someonelse20/Multi-ESC/images/2026-10-27-082640_hyprshot.png

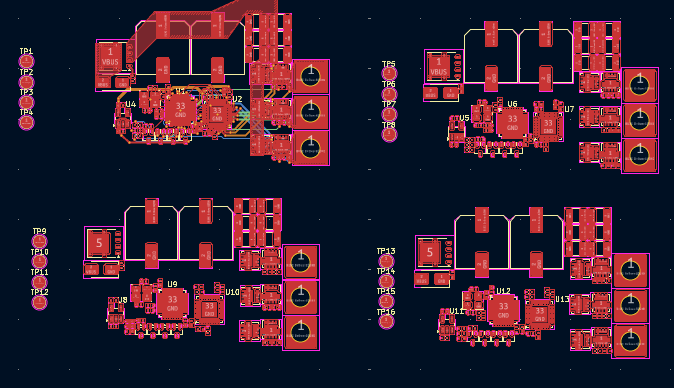
images/2026-10-27-082640_hyprshot.png
