someonelse20/Multi-ESC/images/2026-10-27-082704_hyprshot.png

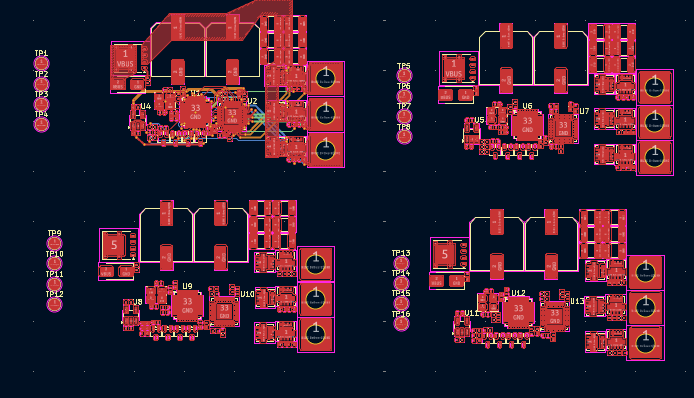
images/2026-10-27-082704_hyprshot.png
