someonelse20/Multi-ESC/production/DigiKeyBOM.csv

Country of Origin may be different at time of shipment.
The HTSUS and ECCN information shown is for informational purposes only and is not a representation or warranty as to the accuracy or reliability of these classifications. All information is provided "as is" and is subject to change without notice. Any use made of the information provided is without recourse to Digi-Key and at the user's risk.
Index | Manufacturer Part Number | Manufacturer Name | Description | Lead Time | Availability | Stock Status | Attrition % | Requested Quantity 1 | Pack Quantity 1 | Pack Type 1 | Digi-Key Part Number 1 | Unit Price 1 | Extended Price 1 | Minimum Order Quantity 1 | Customer Reference | Requested Part Number | Lead Weeks | Datasheet | Reference Designator | US Import Tariff | Note | Part Status | RoHS Status | REACH Status | Moisture Sensitivity Level (MSL) | ECCN | HTSUS | Country of Origin | Environmental Information | Original Part numbers | Unit of Measure | Image | Product Notes
1 | SKRKAEE020 | Alps Alpine | SWITCH TACTILE SPST-NO 0.05A 12V |  | 3,846 | In Stock |  | 2 | 2 | Cut Tape (CT) | 4809-SKRKAEE020CT-ND | 0.41000 | $0.82 | 1 |  | 4809-SKRKAEE020CT-ND | 32 | https://tech.alpsalpine.com/cms.media/product_spec_skrkaee020_en_6e94c25fb8.pdf |  | May apply on shipments to the U.S. |  | Active | ROHS3 Compliant |  | 1 (Unlimited) | EAR99 | 8536.50.9031 | China |  | 4809-SKRKAEE020CT-ND | Each | https://mm.digikey.com/Volume0/opasdata/d220001/medias/images/5355/MFG_SKRKAEE020.jpg
2 | C0603C104K5RACTU | KEMET | CAP CER 0.1UF 50V X7R 0603 |  | 2,150,453 | In Stock |  | 10 | 10 | Cut Tape (CT) | 399-C0603C104K5RACTUCT-ND | 0.07700 | $0.77 | 1 |  | 399-C0603C104K5RACTUCT-ND | 12 | https://yageogroup.com/content/datasheet/asset/file/KEM_C1002_X7R_SMD |  | May apply on shipments to the U.S. |  | Active | ROHS3 Compliant | REACH Unaffected | 1 (Unlimited) | EAR99 | 8532.24.0020 | China |  | 399-C0603C104K5RACTUCT-ND | Each | https://mm.digikey.com/Volume0/opasdata/d220001/derivates/6/003/121/213/cut-tape-render_web%28640x640%29.jpg
3 | CL32B106KBJNNNE | Samsung Electro-Mechanics | CAP CER 10UF 50V X7R 1210 |  | 565,889 | In Stock |  | 30 | 30 | Cut Tape (CT) | 1276-3387-1-ND | 0.42800 | $12.84 | 1 |  | 1276-3387-1-ND | 61 | https://mm.digikey.com/Volume0/opasdata/d220001/medias/docus/41/CL32B106KBJNNNE_Spec.pdf |  | May apply on shipments to the U.S. |  | Active | ROHS3 Compliant | REACH Unaffected | 1 (Unlimited) | EAR99 | 8532.24.0020 | Philippines | https://www.samsungsem.com/files/fileDown.do?key=ed1dfdfa-645e-4252-b707-17f9b1502dd1|https://www.samsungsem.com/global/support/certificate/product-stewardship.do | 1276-3387-1-ND | Each | https://mm.digikey.com/Volume0/opasdata/d220001/medias/images/2537/Ceramic-Capacitor-CL-Series.jpg
4 | CL05A475MO5NUNC | Samsung Electro-Mechanics | CAP CER 4.7UF 16V X5R 0402 | Estimated in-stock date unavailable due to product's market conditions | 10,051 | In Stock |  | 10 | 10 | Cut Tape (CT) | 1276-6836-1-ND | 0.31600 | $3.16 | 1 |  | 1276-6836-1-ND | 61 | https://mm.digikey.com/Volume0/opasdata/d220001/medias/docus/2822/CL05A475MO5NUNC_Spec.pdf |  | May apply on shipments to the U.S. |  | Active | ROHS3 Compliant | REACH Unaffected | 1 (Unlimited) | EAR99 | 8532.24.0020 | Philippines | https://www.samsungsem.com/files/fileDown.do?key=ed1dfdfa-645e-4252-b707-17f9b1502dd1|https://www.samsungsem.com/global/support/certificate/product-stewardship.do | 1276-6836-1-ND | Each | https://mm.digikey.com/Volume0/opasdata/d220001/derivates/6/003/231/753/CL-0402%281005Metric%29_web%28640x640%29.jpg
5 | GCM155R71H104KE02D | Murata Electronics | CAP CER 0.1UF 50V X7R 0402 |  | 3,933,488 | In Stock |  | 20 | 20 | Cut Tape (CT) | 490-10672-1-ND | 0.03500 | $0.70 | 1 |  | 490-10672-1-ND | 21 | https://pim.murata.com/asset/pim4/ceramicCapacitorSMD/GCM155R71H104KE02-01A-EN_PDF_CERAMICCAPACITORSMD |  | May apply on shipments to the U.S. |  | Active | ROHS3 Compliant | REACH Unaffected | 1 (Unlimited) | EAR99 | 8532.24.0020 | Japan |  | 490-10672-1-ND | Each | https://mm.digikey.com/Volume0/opasdata/d220001/derivates/6/003/121/213/cut-tape-render_web%28640x640%29.jpg
6 | UMK107AB7105KA-T | Taiyo Yuden | CAP CER 1UF 50V X7R 0603 |  | 573,908 | In Stock |  | 10 | 10 | Cut Tape (CT) | 587-3247-1-ND | 0.11700 | $1.17 | 1 |  | 587-3247-1-ND | 25 | https://mm.digikey.com/Volume0/opasdata/d220001/medias/docus/506/UMK107AB7105KA-T_SS.pdf |  | May apply on shipments to the U.S. |  | Active | ROHS3 Compliant | REACH Unaffected | 1 (Unlimited) | EAR99 | 8532.24.0020 | Malaysia |  | 587-3247-1-ND | Each | https://mm.digikey.com/Volume0/opasdata/d220001/derivates/6/003/121/213/cut-tape-render_web%28640x640%29.jpg
7 | CL05A105KA5NQNC | Samsung Electro-Mechanics | CAP CER 1UF 25V X5R 0402 | Estimated in-stock date unavailable due to product's market conditions | 1,958,988 | In Stock |  | 20 | 20 | Cut Tape (CT) | 1276-1445-1-ND | 0.10900 | $2.18 | 1 |  | 1276-1445-1-ND | 61 | https://mm.digikey.com/Volume0/opasdata/d220001/medias/docus/41/CL05A105KA5NQNC.pdf |  | May apply on shipments to the U.S. |  | Active | ROHS3 Compliant | REACH Unaffected | 1 (Unlimited) | EAR99 | 8532.24.0020 | Philippines | https://www.samsungsem.com/files/fileDown.do?key=ed1dfdfa-645e-4252-b707-17f9b1502dd1|https://www.samsungsem.com/global/support/certificate/product-stewardship.do | 1276-1445-1-ND | Each | https://mm.digikey.com/Volume0/opasdata/d220001/derivates/6/003/231/753/CL-0402%281005Metric%29_web%28640x640%29.jpg
8 | GCM155R71H103KA55D | Murata Electronics | CAP CER 10000PF 50V X7R 0402 |  | 1,289,886 | In Stock |  | 10 | 10 | Cut Tape (CT) | 490-4762-1-ND | 0.02700 | $0.27 | 1 |  | 490-4762-1-ND | 21 | https://pim.murata.com/asset/pim4/ceramicCapacitorSMD/GCM155R71H103KA55-01A-EN_PDF_CERAMICCAPACITORSMD |  | May apply on shipments to the U.S. |  | Active | ROHS3 Compliant | REACH Unaffected | 1 (Unlimited) | EAR99 | 8532.24.0020 | Philippines |  | 490-4762-1-ND | Each | https://mm.digikey.com/Volume0/opasdata/d220001/derivates/6/003/121/213/cut-tape-render_web%28640x640%29.jpg
9 | GRM1555C1H100FA01D | Murata Electronics | CAP CER 10PF 50V C0G/NP0 0402 |  | 3,026,420 | In Stock |  | 10 | 10 | Cut Tape (CT) | 490-6186-1-ND | 0.04600 | $0.46 | 1 |  | 490-6186-1-ND | 17 | https://mm.digikey.com/Volume0/opasdata/d220001/medias/docus/412/GRM1555C1H100FA01.pdf |  | '- |  | Not For New Designs | ROHS3 Compliant | REACH Unaffected | 1 (Unlimited) | EAR99 | 8532.24.0020 | Japan |  | 490-6186-1-ND | Each | https://mm.digikey.com/Volume0/opasdata/d220001/derivates/6/003/121/213/cut-tape-render_web%28640x640%29.jpg
10 | GRM155R71H473KE14D | Murata Electronics | CAP CER 0.047UF 50V X7R 0402 |  | 514,933 | In Stock |  | 10 | 10 | Cut Tape (CT) | 490-10702-1-ND | 0.02300 | $0.23 | 1 |  | 490-10702-1-ND | 17 | https://mm.digikey.com/Volume0/opasdata/d220001/medias/docus/8942/490_Chip_Multilayer_CAT2021_MLCC.pdf |  | May apply on shipments to the U.S. |  | Active | ROHS3 Compliant | REACH Unaffected | 1 (Unlimited) | EAR99 | 8532.24.0020 | Japan |  | 490-10702-1-ND | Each | https://mm.digikey.com/Volume0/opasdata/d220001/derivates/6/003/121/213/cut-tape-render_web%28640x640%29.jpg
11 | A768MS277M1GLAE022 | KEMET | CAP ALUM POLY 270UF 20% 40V SMD |  | 15,595 | In Stock |  | 10 | 10 | Cut Tape (CT) | 399-A768MS277M1GLAE022CT-ND | 0.78700 | $7.87 | 1 |  | 399-A768MS277M1GLAE022CT-ND | 26 | https://yageogroup.com/content/datasheet/asset/file/KEM_A4088_A768 |  | May apply on shipments to the U.S. |  | Active | ROHS3 Compliant | REACH Unaffected | Not Applicable | EAR99 | 8532.22.0020 | China |  | 399-A768MS277M1GLAE022CT-ND | Each | https://mm.digikey.com/Volume0/opasdata/d220001/medias/images/1018/MFG_series_a768.jpg
12 | 35PX1000MEFC10X20 | Rubycon | CAP ALUM 1000UF 20% 35V RADIAL |  | 27,609 | In Stock |  | 2 | 2 | Bulk | 1189-1745-ND | 1.00000 | $2.00 | 1 |  | 1189-1745-ND | 20 | https://www.rubycon.co.jp/wp-content/uploads/catalog-aluminum/PX.pdf |  | May apply on shipments to the U.S. |  | Active | ROHS3 Compliant | REACH Unaffected | Not Applicable | EAR99 | 8532.22.0020 | Indonesia | https://mm.digikey.com/Volume0/opasdata/d220001/medias/docus/8961/Rubycon%20CA%20Prop%2065%20Statement.pdf | 1189-1745-ND | Each | https://mm.digikey.com/Volume0/opasdata/d220001/medias/images/525/63PX330MEFC10X20.JPG
13 | SMAJ40CA | Littelfuse Inc. | TVS DIODE 40VWM 64.5VC DO214AC |  | 73,775 | In Stock |  | 10 | 10 | Cut Tape (CT) | 18-SMAJ40CACT-ND | 0.29500 | $2.95 | 1 |  | 18-SMAJ40CACT-ND | 35 | https://www.littelfuse.com/media?itemid=13C2A823-03B8-4D1F-9DDC-9B44670AED9D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 |  | May apply on shipments to the U.S. |  | Active | ROHS3 Compliant | REACH Affected | 1 (Unlimited) | EAR99 | 8541.10.0080 | China | https://www.littelfusebusinesscenter.com/LFWeb/rohs_upload/RoHS_Certificate_of_Compliance/CoC_RoHS9_SMAJ40CA_04-25-2019.pdf | 18-SMAJ40CACT-ND | Each | https://mm.digikey.com/Volume0/opasdata/d220001/derivates/6/001/123/964/118%7EDO214AC%28SMA%29%7E%7E2_web%28640x640%29.jpg
14 | BAT54CW | Shenzhen Slkormicro Semicon Co., Ltd. | 30V 1 PAIR OF COMMON CATHODES 1V |  | 59,619 | In Stock |  | 20 | 20 | Cut Tape (CT) | 5399-BAT54CWCT-ND | 0.08200 | $1.64 | 1 |  | 5399-BAT54CWCT-ND | 2 | https://mm.digikey.com/Volume0/opasdata/d220001/medias/docus/7136/5399_BAT54CW%20SOT-323.pdf |  | '- |  | Active | ROHS3 Compliant |  | 1 (Unlimited) | EAR99 | 8541.10.0070 | China |  | 5399-BAT54CWCT-ND | Each | https://mm.digikey.com/Volume0/opasdata/d220001/derivates/6/003/243/453/5399%7ESOT323%7E%7E3-View-2_web%28640x640%29.jpg
15 | CDRH127NP-4R7NC | Sumida America Components Inc. | FIXED IND 4.7UH 6.8A 15.8 MOHM |  | 952 | In Stock |  | 2 | 2 | Cut Tape (CT) | 308-1473-1-ND | 1.60000 | $3.20 | 1 |  | 308-1473-1-ND | 26 | https://products.sumida.com/products/pdf/CDRH127.pdf |  | May apply on shipments to the U.S. |  | Active | ROHS3 Compliant | Vendor Undefined | 1 (Unlimited) | EAR99 | 8504.50.4000 | Vietnam | https://www.sumida.com/userfiles/INFO_CENTER/CERTIFICATIONS/Sumida-RoHS-Certificate-ver20190614.pdf | 308-1473-1-ND | Each | https://mm.digikey.com/Volume0/opasdata/d220001/medias/images/2505/CDRH127%20SERIES.jpg
16 | DI030N10PT-AQ | Diotec Semiconductor | MOSFET, POWERQFN 3X3, N, 100V, 3 |  | 4,965 | In Stock |  | 30 | 30 | Cut Tape (CT) | 4878-DI030N10PT-AQCT-ND | 0.44000 | $13.20 | 1 |  | 4878-DI030N10PT-AQCT-ND | 12 | https://diotec.com/request/datasheet/di030n10pt.pdf |  | May apply on shipments to the U.S. |  | Active | ROHS3 Compliant | REACH Unaffected | 3 (168 Hours) | '- | '- | China |  | 4878-DI030N10PT-AQCT-ND | Each | https://mm.digikey.com/Volume0/opasdata/d220001/derivates/6/003/257/406/MFG_DI030N10PT-AQ_web%28640x640%29.jpg
17 | SQJ457EP-T1_GE3 | Vishay Siliconix | MOSFET P-CH 60V 36A PPAK SO-8 |  | 75,749 | In Stock |  | 5 | 5 | Cut Tape (CT) | SQJ457EP-T1_GE3CT-ND | 1.61000 | $8.05 | 1 |  | SQJ457EP-T1_GE3CT-ND | 33 | https://www.vishay.com/docs/76628/sqj457ep.pdf |  | May apply on shipments to the U.S. |  | Active | ROHS3 Compliant | Vendor Undefined | 1 (Unlimited) | EAR99 | 8541.29.0055 | Germany |  | SQJ457EP-T1_GE3CT-ND | Each | https://mm.digikey.com/Volume0/opasdata/d220001/derivates/6/300/356/461/742%3B%205976%20Single%3B%20DP%3B%208_web%28640x640%29.jpg
18 | ERJ-2GEJ104X | Panasonic Industry | RES SMD 100K OHM 5% 1/10W 0402 |  | 5,727,419 | In Stock |  | 10 | 10 | Cut Tape (CT) | P100KJCT-ND | 0.02900 | $0.29 | 1 |  | P100KJCT-ND | 15 | https://industrial.panasonic.com/cdbs/www-data/pdf/RDA0000/AOA0000C301.pdf |  | May apply on shipments to the U.S. |  | Active | ROHS3 Compliant | REACH Unaffected | 1 (Unlimited) | EAR99 | 8533.21.0030 | China | https://industrial.panasonic.com/cdbs/www-cgi/auto-publishing.cgi?type=ROSU&region=WW&layer=4&cd=AOA0002 | P100KJCT-ND | Each | https://mm.digikey.com/Volume0/opasdata/d220001/derivates/6/003/121/213/cut-tape-render_web%28640x640%29.jpg
19 | RN73R1ETTP3202B25 | KOA Speer Electronics, Inc. | RES 32K OHM 0.1% 1/16W 0402 |  | 2,699 | In Stock |  | 10 | 10 | Cut Tape (CT) | 2019-RN73R1ETTP3202B25CT-ND | 0.07200 | $0.72 | 1 |  | 2019-RN73R1ETTP3202B25CT-ND | 8 | https://www.koaspeer.com/pdfs/RN73R.pdf |  | May apply on shipments to the U.S. |  | Active | ROHS3 Compliant | REACH Unaffected | 1 (Unlimited) | EAR99 | 8533.21.0030 | Japan | https://www.koaglobal.com/product/common/rohs|https://mm.digikey.com/Volume0/opasdata/d220001/medias/docus/5718/2019_KOA%20Speer%20RoHS3%20Statement.pdf|https://mm.digikey.com/Volume0/opasdata/d220001/medias/docus/8955/KOA%20Speer%20CA%20Prop%2065%20Statement.pdf | 2019-RN73R1ETTP3202B25CT-ND | Each | https://mm.digikey.com/Volume0/opasdata/d220001/medias/images/696/KOA-Speer-RK73Z-0402-%281005-Metric%29.jpg
20 | RC0402FR-0730K9L | YAGEO | RES 30.9K OHM 1% 1/16W 0402 |  | 247,654 | In Stock |  | 10 | 10 | Cut Tape (CT) | YAG3110CT-ND | 0.02300 | $0.23 | 1 |  | YAG3110CT-ND | 24 | https://yageogroup.com/content/datasheet/asset/file/PYU-RC_GROUP_51_ROHS_L |  | May apply on shipments to the U.S. |  | Active | ROHS3 Compliant | REACH Unaffected | 1 (Unlimited) | EAR99 | 8533.21.0030 | Taiwan | https://www.yageogroup.com/content/Resource%20Library/Product%20Environmental%20Compliance/RoHS_Compliance_YAGEO.pdf | YAG3110CT-ND | Each | https://mm.digikey.com/Volume0/opasdata/d220001/medias/images/4849/13_0402-%281005-metric%29.jpg
21 | RMCF0402FT10K0 | Stackpole Electronics Inc | RES 10K OHM 1% 1/16W 0402 |  | 10,547,187 | In Stock |  | 25 | 25 | Cut Tape (CT) | RMCF0402FT10K0CT-ND | 0.01440 | $0.36 | 1 |  | RMCF0402FT10K0CT-ND | 22 | https://www.seielect.com/catalog/SEI-RMCF_RMCP.pdf |  | May apply on shipments to the U.S. |  | Active | ROHS3 Compliant | REACH Unaffected | 1 (Unlimited) | EAR99 | 8533.21.0030 | Taiwan | https://www.seielect.com/catalog/SEI-RoHS_Compliance_Status.pdf|https://www.seielect.com/catalog/reach.pdf|https://www.seielect.com/catalog/sei-coc%20prop%2065.pdf | RMCF0402FT10K0CT-ND | Each | https://mm.digikey.com/Volume0/opasdata/d220001/derivates/6/003/121/213/cut-tape-render_web%28640x640%29.jpg
22 | ERJ-2RKF1001X | Panasonic Industry | RES SMD 1K OHM 1% 1/10W 0402 |  | 4,922,793 | In Stock |  | 10 | 10 | Cut Tape (CT) | P1.00KLCT-ND | 0.03100 | $0.31 | 1 |  | P1.00KLCT-ND | 15 | https://industrial.panasonic.com/cdbs/www-data/pdf/RDA0000/AOA0000C304.pdf |  | May apply on shipments to the U.S. |  | Active | ROHS3 Compliant | REACH Unaffected | 1 (Unlimited) | EAR99 | 8533.21.0030 | China | https://industrial.panasonic.com/cdbs/www-cgi/auto-publishing.cgi?type=ROSU&region=WW&layer=4&cd=AOA0002 | P1.00KLCT-ND | Each | https://mm.digikey.com/Volume0/opasdata/d220001/derivates/6/003/121/213/cut-tape-render_web%28640x640%29.jpg
23 | RC0402FR-07200KL | YAGEO | RES 200K OHM 1% 1/16W 0402 |  | 1,147,532 | In Stock |  | 30 | 30 | Cut Tape (CT) | 311-200KLRCT-ND | 0.01680 | $0.50 | 1 |  | 311-200KLRCT-ND | 24 | https://yageogroup.com/content/datasheet/asset/file/PYU-RC_GROUP_51_ROHS_L |  | May apply on shipments to the U.S. |  | Active | ROHS3 Compliant | REACH Unaffected | 1 (Unlimited) | EAR99 | 8533.21.0030 | Taiwan | https://www.yageogroup.com/content/Resource%20Library/Product%20Environmental%20Compliance/RoHS_Compliance_YAGEO.pdf | 311-200KLRCT-ND | Each | https://mm.digikey.com/Volume0/opasdata/d220001/derivates/6/003/121/213/cut-tape-render_web%28640x640%29.jpg
24 | RC0402FR-0718KL | YAGEO | RES 18K OHM 1% 1/16W 0402 |  | 176,187 | In Stock |  | 25 | 25 | Cut Tape (CT) | 311-18.0KLRCT-ND | 0.01680 | $0.42 | 1 |  | 311-18.0KLRCT-ND | 24 | https://yageogroup.com/content/datasheet/asset/file/PYU-RC_GROUP_51_ROHS_L |  | May apply on shipments to the U.S. |  | Active | ROHS3 Compliant | REACH Unaffected | 1 (Unlimited) | EAR99 | 8533.21.0030 | Taiwan | https://www.yageogroup.com/content/Resource%20Library/Product%20Environmental%20Compliance/RoHS_Compliance_YAGEO.pdf | 311-18.0KLRCT-ND | Each | https://mm.digikey.com/Volume0/opasdata/d220001/medias/images/4849/13_0402-%281005-metric%29.jpg
25 | STM32F318K8U6 | STMicroelectronics | IC MCU 32BIT 64KB FLASH 32UFQFPN |  | 2,895 | In Stock |  | 4 | 4 | Tray | 497-18931-ND | 5.35000 | $21.40 | 1 |  | 497-18931-ND | 40 | https://www.st.com/content/ccc/resource/technical/document/datasheet/99/e9/35/90/60/3d/4b/f4/DM00115350.pdf/files/DM00115350.pdf/jcr:content/translations/en.D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 |  | May apply on shipments to the U.S. |  | Active | ROHS3 Compliant | REACH Unaffected | 3 (168 Hours) | 3A991A2 | 8542.31.0025 | China |  | 497-18931-ND | Each | https://mm.digikey.com/Volume0/opasdata/d220001/medias/images/6255/497%7EA0B8_ME%7EU%7E32.jpg | No Backorders Allowed.
26 | DRV8320SRTVR | Texas Instruments | IC MTR DRV MULTPHAS 6-60V 32WQFN |  | 2,447 | In Stock |  | 4 | 4 | Cut Tape (CT) | 296-50725-1-ND | 3.69000 | $14.76 | 1 |  | 296-50725-1-ND | 26 | https://www.ti.com/general/docs/suppproductinfo.tsp?distId=10 |  | '- |  | Active | ROHS3 Compliant | REACH Unaffected | 2 (1 Year) | EAR99 | 8542.39.0070 | United States |  | 296-50725-1-ND | Each | https://mm.digikey.com/Volume0/opasdata/d220001/medias/images/6222/296%7E4206245%7ERTV%7E32.jpg
27 | LMR51450FNDRRR | Texas Instruments | IC REG BUCK ADJ 5A 12WSON |  | 12,395 | In Stock |  | 1 | 1 | Cut Tape (CT) | 296-LMR51450FNDRRRCT-ND | 2.28000 | $2.28 | 1 |  | 296-LMR51450FNDRRRCT-ND | 26 | https://www.ti.com/lit/ds/symlink/lmr51440.pdf |  | May apply on shipments to the U.S. |  | Active | ROHS3 Compliant | REACH Unaffected | 1 (Unlimited) | EAR99 | 8542.39.0070 | China |  | 296-LMR51450FNDRRRCT-ND | Each | https://mm.digikey.com/Volume0/opasdata/d220001/derivates/6/002/226/851/296%7E4227052%7EDRR%7E12_web%28640x640%29.jpg
28 | MIC5504-1.8YM5-TR | Microchip Technology | IC REG LINEAR 1.8V 300MA SOT23-5 |  | 69,894 | In Stock |  | 5 | 5 | Cut Tape (CT) | 576-4879-1-ND | 0.16000 | $0.80 | 1 |  | 576-4879-1-ND | 25 | https://ww1.microchip.com/downloads/en/DeviceDoc/MIC5501-02-03-04-300mA-Single-Output-LDO-in-Small-Packages-DS20006006B.pdf |  | '- |  | Active | ROHS3 Compliant | REACH Unaffected | 1 (Unlimited) | EAR99 | 8542.39.0090 | Thailand | https://ww1.microchip.com/downloads/aemDocuments/documents/corporate-responsibilty/environmental/product-regulatory-information/Semiconductor_EnvCoC.pdf|https://ww1.microchip.com/downloads/aemDocuments/documents/corporate-responsibilty/environmental/product-regulatory-information/Microchip_REACH_Statement.pdf | 576-4879-1-ND | Each | https://mm.digikey.com/Volume0/opasdata/d220001/medias/images/4195/150%7ESOT23-5%7EM5%7E5.JPG
29 | ECS-80-8-33Q-ADS | ECS Inc. | CRYSTAL 8.0000MHZ 8PF SMD |  | 22,595 | In Stock |  | 4 | 4 | Cut Tape (CT) | 50-ECS-80-8-33Q-ACT-ND | 0.97000 | $3.88 | 1 |  | 50-ECS-80-8-33Q-ACT-ND | 19 | https://ecsxtal.com/store/pdf/ECX-33Q.pdf |  | May apply on shipments to the U.S. |  | Active | ROHS3 Compliant | REACH Unaffected | 1 (Unlimited) | EAR99 | 8541.60.0050 | Taiwan |  | 50-ECS-80-8-33Q-ACT-ND | Each | https://mm.digikey.com/Volume0/opasdata/d220001/medias/images/717/MFG_ECS-400-8-33Q-ADS-TR.jpg
