someonelse20/Multi-ESC/production/BOM.csv

Reference | Qty | Value | DNP | Exclude from BOM | Exclude from Board | Exclude from Simulation | Exclude from Position Files | Footprint | Datasheet | MPN
BOOT1 | 1 | SW_Push |  |  |  |  | ${EXCLUDE_FROM_POS_FILES} | Button_Switch_SMD:SW_Push_SPST_NO_Alps_SKRK |  | SKRKAEE020
C1,C2,C3,C4 | 4 | 100nF |  |  |  |  | ${EXCLUDE_FROM_POS_FILES} | Capacitor_SMD:C_0603_1608Metric |  | C0603C104K5RACTU
C5,C6,C7,C24,C25,C26,C27,C28,C29,C44,C45,C47,C49,C50,C52,C66,C67,C69,C71,C72,C74,C88,C89,C91,C93,C94,C96 | 27 | 10uF |  |  |  |  | ${EXCLUDE_FROM_POS_FILES} | Capacitor_SMD:C_1210_3225Metric |  | CL32B106KBJNNNE
C8,C34,C56,C78 | 4 | 4.7uF |  |  |  |  | ${EXCLUDE_FROM_POS_FILES} | Capacitor_SMD:C_0402_1005Metric |  | CL05A475MO5NUNC
C9,C10,C20,C35,C36,C48,C57,C58,C70,C79,C80,C92 | 12 | 100nF |  |  |  |  | ${EXCLUDE_FROM_POS_FILES} | Capacitor_SMD:C_0402_1005Metric |  | GCM155R71H104KE02D
C11,C17,C19,C37,C46,C51,C59,C68,C73,C81,C90,C95 | 12 | 1uF |  |  |  |  | ${EXCLUDE_FROM_POS_FILES} | Capacitor_SMD:C_0402_1005Metric |  | CL05A105KA5NQNC
C12,C21,C32,C38,C54,C60,C76,C82 | 8 | 10nF |  |  |  |  | ${EXCLUDE_FROM_POS_FILES} | Capacitor_SMD:C_0402_1005Metric |  | GCM155R71H103KA55D
C13,C14,C31,C33,C53,C55,C75,C77 | 8 | 1uF |  |  |  |  | ${EXCLUDE_FROM_POS_FILES} | Capacitor_SMD:C_0603_1608Metric |  | UMK107AB7105KA-T
C15,C16,C39,C40,C61,C62,C83,C84 | 8 | 10pF |  |  |  |  | ${EXCLUDE_FROM_POS_FILES} | Capacitor_SMD:C_0402_1005Metric |  | GRM1555C1H100FA01D
C18,C43,C65,C87 | 4 | 47nF |  |  |  |  | ${EXCLUDE_FROM_POS_FILES} | Capacitor_SMD:C_0402_1005Metric |  | GRM155R71H473KE14D
C22,C23,C41,C42,C63,C64,C85,C86 | 8 | 270uF |  |  |  |  | ${EXCLUDE_FROM_POS_FILES} | Capacitor_SMD:C_Elec_10x10.2 |  | A768MS277M1GLAE022
C30 | 1 | 1000uF |  |  |  |  | ${EXCLUDE_FROM_POS_FILES} |  |  | 35PX1000MEFC10X20
D1,D2,D11,D16,D21 | 5 | SMAJ40CA |  |  |  |  | ${EXCLUDE_FROM_POS_FILES} | Diode_SMD:D_SMA | https://www.littelfuse.com/media?itemid=75e32973-b177-4ee3-a0ff-cedaf1abdb93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 | SMAJ40CA
D4,D6,D7,D8,D9,D10,D12,D13,D14,D15,D17,D18,D19,D23,D24,D25 | 16 | BAT54CW |  |  |  |  | ${EXCLUDE_FROM_POS_FILES} | Package_TO_SOT_SMD:SOT-323_SC-70 | https://assets.nexperia.com/documents/data-sheet/BAT54W_SER.pdf | BAT54CW
J1,J2,J3,J4,J5,J6,J7,J8,J9,J10,J11,J12,J13,J14 | 14 | Conn_01x01 |  |  |  |  | ${EXCLUDE_FROM_POS_FILES} | Connector_Wire:SolderWire-4sqmm_1x01_D3mm_OD6mm
J15,J16 | 2 | Conn_01x01 |  |  |  |  | ${EXCLUDE_FROM_POS_FILES} | Connector_Wire:SolderWire-2sqmm_1x01_D2mm_OD3.9mm
J17 | 1 | Conn_01x03 |  |  |  |  | ${EXCLUDE_FROM_POS_FILES} | Connector_PinSocket_2.54mm:PinSocket_1x03_P2.54mm_Vertical
J18 | 1 | Conn_01x05 |  |  |  |  | ${EXCLUDE_FROM_POS_FILES} | Connector_PinSocket_2.54mm:PinSocket_1x05_P2.54mm_Vertical
L1 | 1 | 4.7uH |  |  |  |  | ${EXCLUDE_FROM_POS_FILES} | Inductor_SMD:L_Pulse_PA4320 |  | CDRH127NP-4R7NC
Q1,Q2,Q3,Q4,Q5,Q6,Q8,Q9,Q10,Q11,Q12,Q13,Q15,Q16,Q17,Q18,Q19,Q20,Q22,Q23,Q24,Q25,Q26,Q27 | 24 | DI030N10PT-AQ |  |  |  |  | ${EXCLUDE_FROM_POS_FILES} | Diode_SMD:D_QFN_3.3x3.3mm_P0.65mm |  | DI030N10PT-AQ
Q7,Q14,Q21,Q28 | 4 | Q_PMOS_DGS |  |  |  |  | ${EXCLUDE_FROM_POS_FILES} | Package_SO:PowerPAK_SO-8L_Single |  | SQJ457EP-T1_GE3
R1,R4 | 2 | 100K |  |  |  |  | ${EXCLUDE_FROM_POS_FILES} | Resistor_SMD:R_0402_1005Metric |  | ERJ-2GEJ104X
R2 | 1 | 32K |  |  |  |  | ${EXCLUDE_FROM_POS_FILES} | Resistor_SMD:R_0402_1005Metric |  | RN73R1ETTP3202B25
R3 | 1 | 30.9K |  |  |  |  | ${EXCLUDE_FROM_POS_FILES} | Resistor_SMD:R_0402_1005Metric |  | RC0402FR-0730K9L
R5,R6,R8,R28,R29,R30,R41,R42,R43,R54,R55,R56,R57 | 13 | 10K |  |  |  |  | ${EXCLUDE_FROM_POS_FILES} | Resistor_SMD:R_0402_1005Metric |  | RMCF0402FT10K0
R7,R27,R40,R53 | 4 | 1K |  |  |  |  | ${EXCLUDE_FROM_POS_FILES} | Resistor_SMD:R_0402_1005Metric |  | ERJ-2RKF1001X
R9,R11,R13,R15,R16,R17,R18,R19,R20,R21,R23,R25,R31,R32,R33,R34,R36,R38,R44,R45,R46,R47,R49,R51 | 24 | 200K |  |  |  |  | ${EXCLUDE_FROM_POS_FILES} | Resistor_SMD:R_0402_1005Metric |  | RC0402FR-07200KL
R10,R12,R14,R22,R24,R26,R35,R37,R39,R48,R50,R52 | 12 | 18K |  |  |  |  | ${EXCLUDE_FROM_POS_FILES} | Resistor_SMD:R_0402_1005Metric |  | RC0402FR-0718KL
TP1,TP2,TP3,TP4,TP5,TP6,TP7,TP8,TP9,TP10,TP11,TP12,TP13,TP14,TP15,TP16 | 16 | TestPoint |  |  |  |  | ${EXCLUDE_FROM_POS_FILES} | TestPoint:TestPoint_Pad_D2.0mm
U1,U6,U9,U12 | 4 | STM32F318K8Ux |  |  |  |  | ${EXCLUDE_FROM_POS_FILES} | Package_DFN_QFN:QFN-32-1EP_5x5mm_P0.5mm_EP3.45x3.45mm | https://www.st.com/resource/en/datasheet/stm32f318k8.pdf | STM32F318K8U6
U2,U7,U10,U13 | 4 | DRV8320SR |  |  |  |  | ${EXCLUDE_FROM_POS_FILES} | Package_DFN_QFN:WQFN-32-1EP_5x5mm_P0.5mm_EP3.1x3.1mm | https://www.ti.com/general/docs/suppproductinfo.tsp?distId=10 | DRV8320SRTVR
U3 | 1 | LMR51450FN |  |  |  |  | ${EXCLUDE_FROM_POS_FILES} | Package_SON:WSON-12-1EP_3x3mm_P0.5mm_EP1.5x2.5mm_ThermalVias | https://www.ti.com/lit/ds/symlink/lmr51450.pdf | LMR51450FNDRRR
U4,U5,U8,U11 | 4 | MIC5504-1.8YM5 |  |  |  |  | ${EXCLUDE_FROM_POS_FILES} | Package_TO_SOT_SMD:SOT-23-5 | http://ww1.microchip.com/downloads/en/DeviceDoc/MIC550X.pdf | MIC5504-1.8YM5-TR
Y1,Y2,Y3,Y4 | 4 | 8MHz |  |  |  |  | ${EXCLUDE_FROM_POS_FILES} | Crystal:Crystal_SMD_3225-4Pin_3.2x2.5mm |  | ECS-80-8-33Q-ADS
