someonelse20/Multi-ESC/JOURNAL.md

---
title: "Multi ESC"
author: "Someonelse"
description: "A custom 4 in 1 drone ESC"
created_at: "2026-10-7"
---

# October 10: Selected initial parts

I started by selecting the parts. Since there will be four identical motor driver circuits I will be trying kicad's sheets feature to make one driver circuit and copy it four times. I want this circuit to do two functions: to drive four brushless motors and to provide a stable 3.3v to the rest of the drone. Because this is the board connected to the battery it makes sense to also put the primary regulator on it too. For this I chose the LMR51450FN as has the specs I need with 5 amps out and is pretty cheap. I had to make a custom symbol for this because kicad didn't have one.

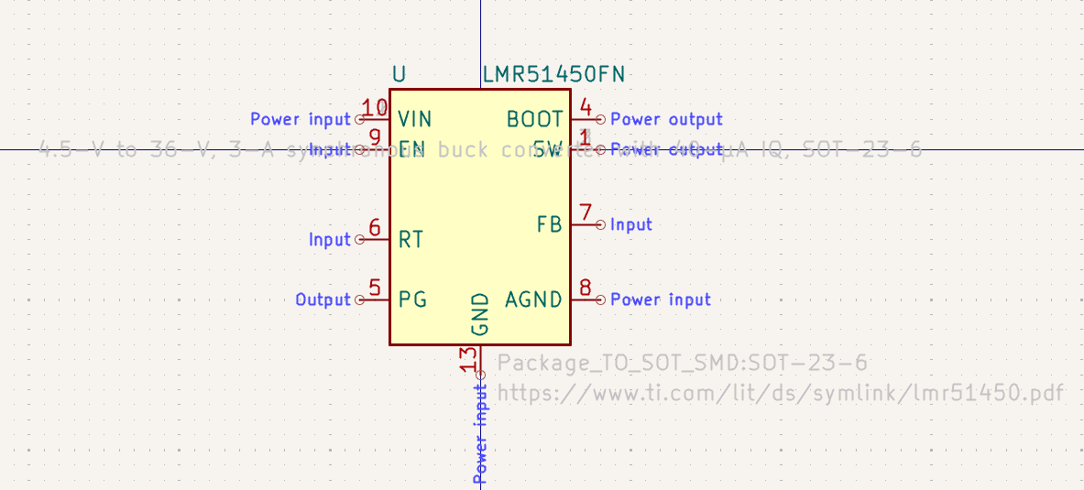
[picture p7: images/LMR51450FN-symbol.png]
Regulator symbol


For the mcu for each driver I chose the STM32F318K8U6 as it was one of the cheapest ones I could find from ST's F3 or G4 lines which are made for signal processing. Even still each mcu is $5 and if I find a cheaper one that will do the job I'll use that instead. For the gate driver I chose the DRV8320S as I've worked with TI gate drivers before and this one was also fairly cheap. Kicad didn't have a footprint for it so I modified the foot print for the DRV8311S. 

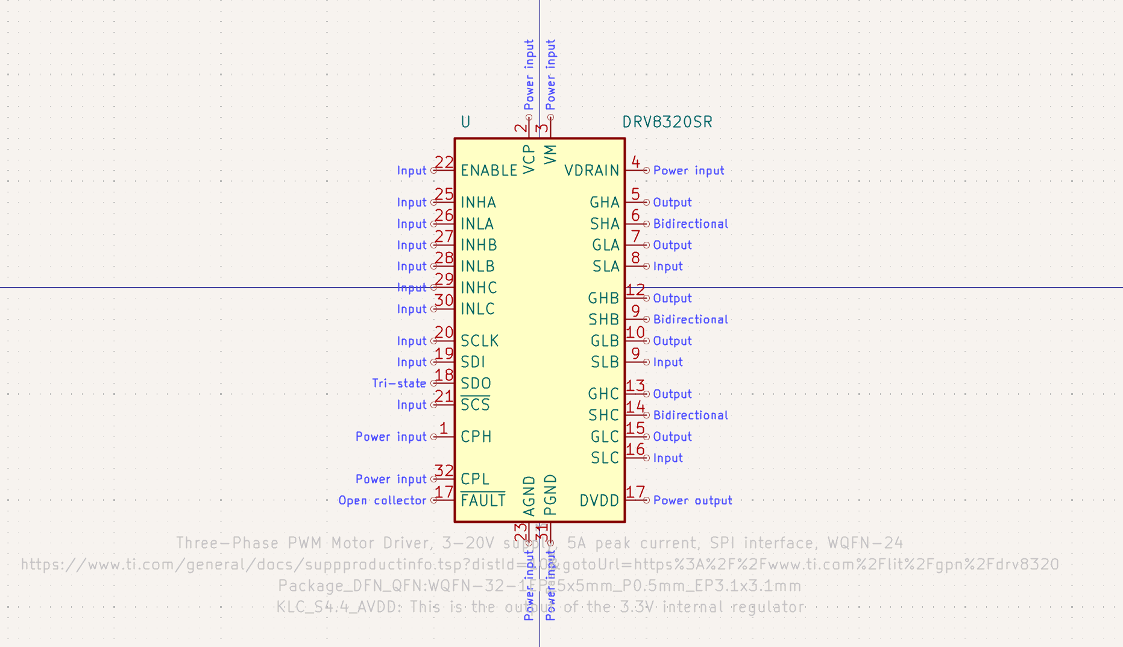
[picture p8: images/DRV8320S-symbol.png]
Gate driver symbol


I then chose a mosfet for the actual gates. I found the DI030N10PT-AQ on digikey which was surprisingly cheap and was rated for 30A and 100V which is plenty. 

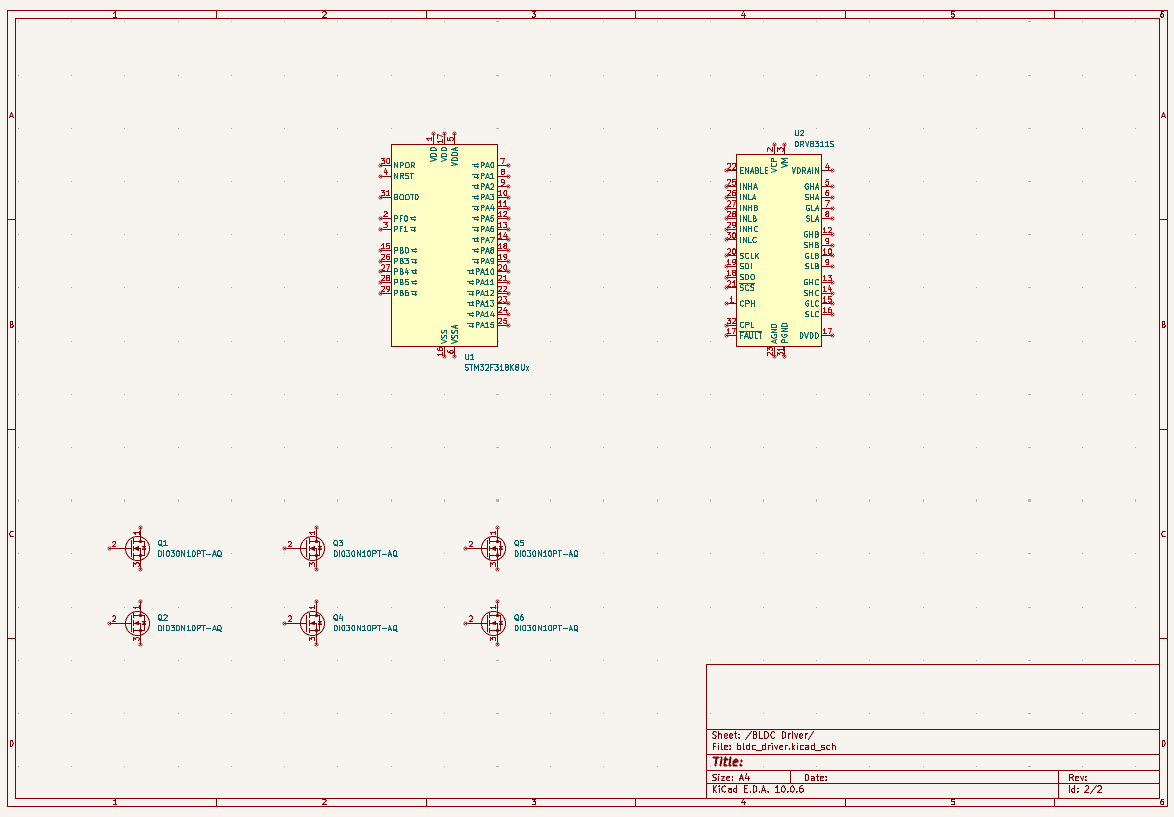
[picture p9: images/schematic-1.png]
initial esc schematic


**Total time spent: 3 hours**

# October 13: Wired regulator schematic

I decided to start wiring the regulator first. TI has a really nice tool that generates a schematic which I used.

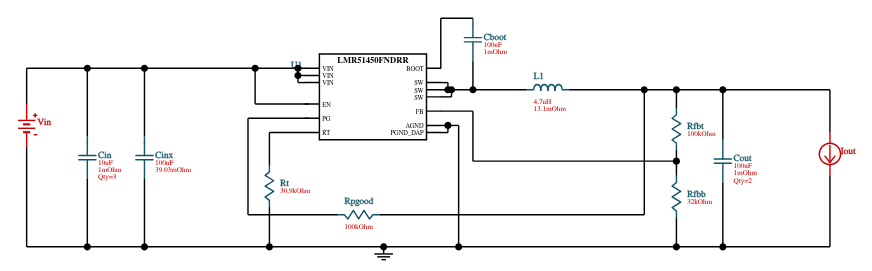
[picture p10: images/reg_ref_circuit.png]
Regulator reference schematic


I then copied this over to kicad.

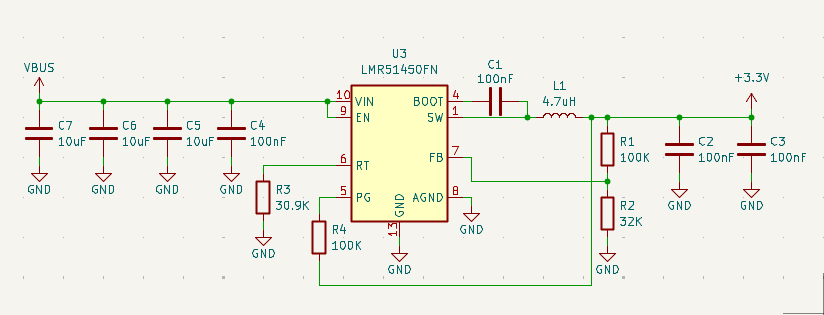
[picture p11: images/reg_circuit-1.png]
Regulator circuit


**Total time spent: 1 hours**

# October 13: Wired MCU

Next I went to routing the mcu for the driver. After looking over the datasheet the mcu needs a separate 1.8v digital supply so I added a simple ldo regulator. The analog voltage will still be 3.3v because the mcu supports that and because I will be measuring high voltage which will be steped down and the lower the max voltage the less accurate it is. I opened up STM32CubeMX to get the pinout and tried a few times to get everything I need. It was a bit tricky because the mcu doesn't have many pins and I need a lot of different functions. After a few tries I managed to get everything I wanted. At first I wasn't sure if I should add SPI for the gate driver because I thought I wouldn't have enough pins and I might need a level shifter. After checking the gate driver datasheet it does support 1.8v digital supply so I chose to add in the SPI.

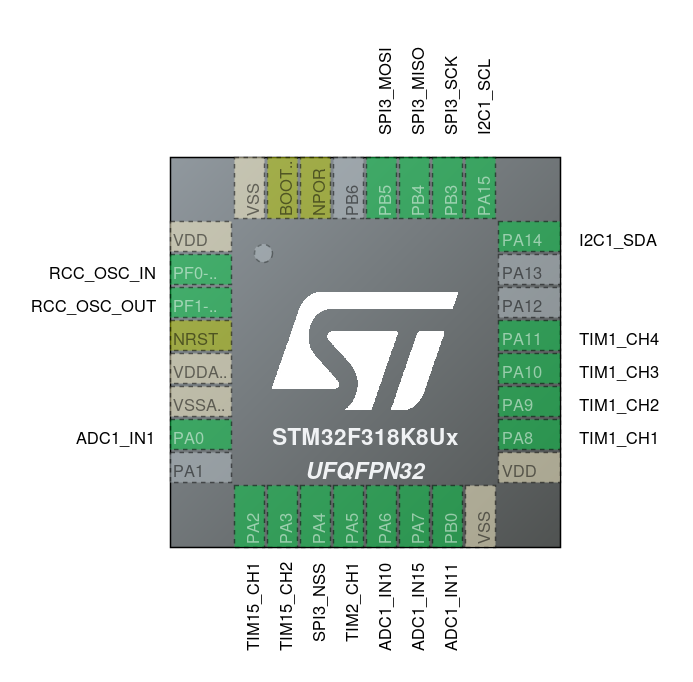
[picture p12: images/mcu_pinout-1.png]
STM32CubeMX pinout


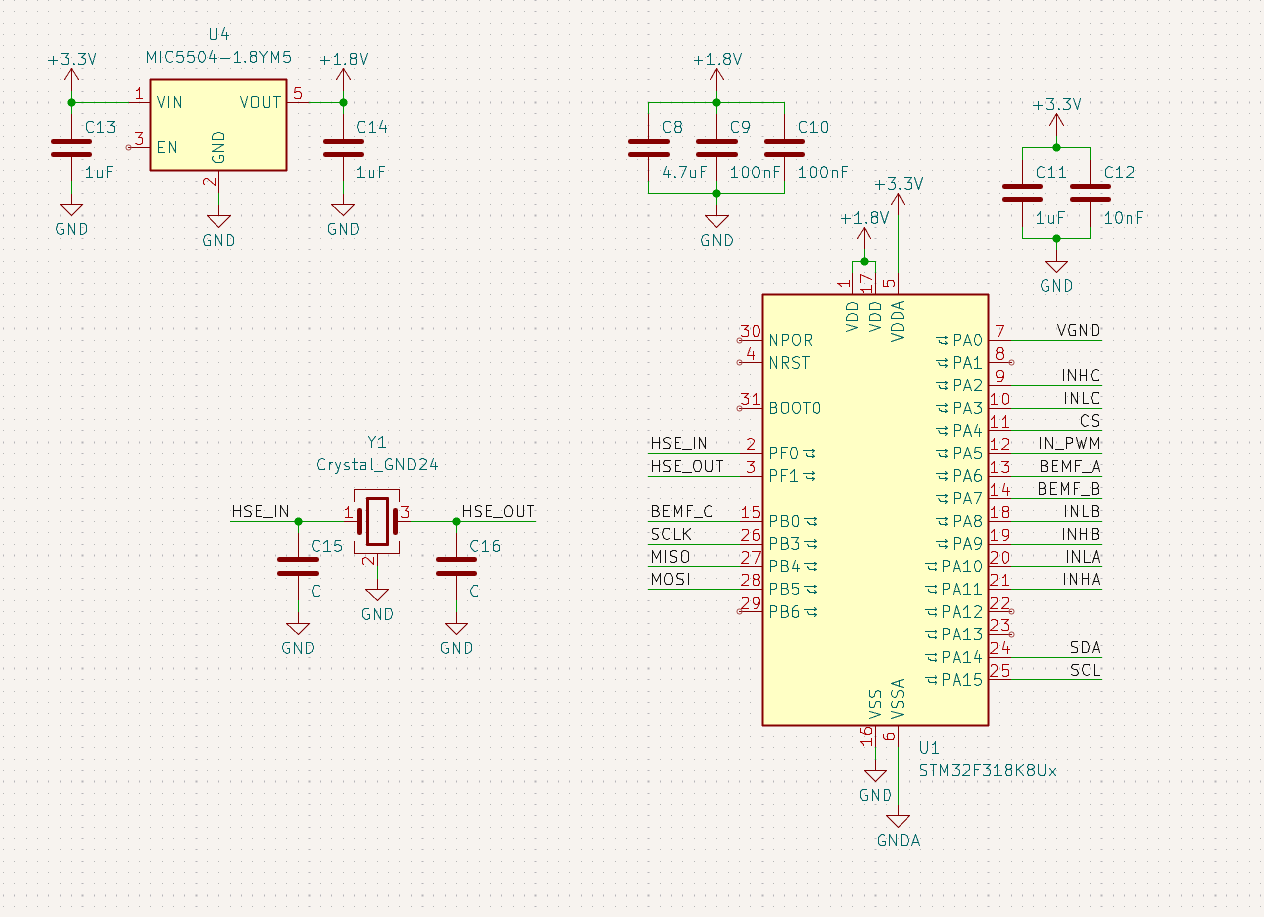
[picture p13: images/mcu_circuit-1.png]
MCU circuit


**Total time spent: 2 hours**

# October 14: Wired gate driver circuit

Right after the last journal I realized I had no way of programming the mcu. The datasheet said it could be flashed through SPI1 which I was using but through different pins. I decided to add test points for a uart interface so that way I could put it into boot mode and flash it that way. I also added test points for the reset pins and added external labels for the sheet.

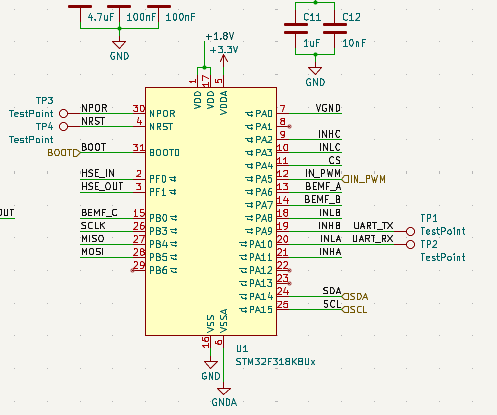
[picture p14: images/mcu_circuit-2.png]
Updated MCU circuit


I then went on to wire up the gate driver. I followed the datasheet and double checked that everything will work with 1.8v instead of the normal 3.3v. From what I can find it will still work fine but I think I'll reach out to TI to be absolutely sure.

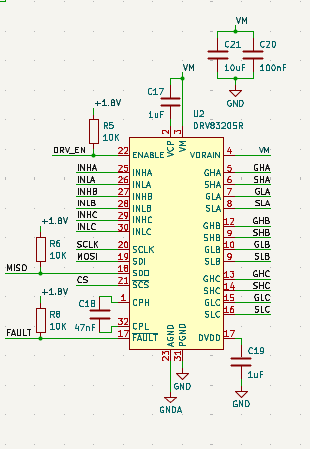
[picture p15: images/driver_circuit-1.png]
Driver circuit


Next I added a TVS diode for overvoltage protection. The gate driver is rated for 60v and the mosfets for 100v. I chose a maximum voltage of 40v to give me plenty of headway. I then added a p channel mosfet for reverse current protection because the motor can drive the current backwards.

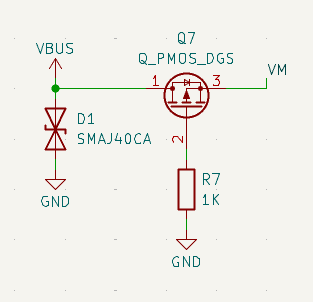
[picture p16: images/power_circuit-1.png]
Power protection circuit


Then I went to the actual inverter circuit. For a previous board I added a bunch of fancy r-c snubbers and shunt resistors but I decided to keep it simple here because I'm not going for peak performance. The gate driver doesn't have current measurement anyway so I routed it up with little extra components. I did add voltage dividors to measure each line voltage safely.

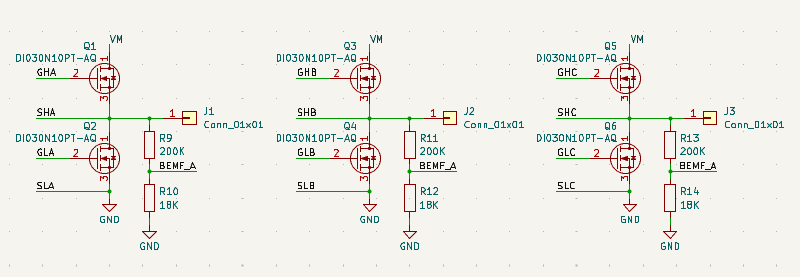
[picture p17: images/gate_circuit-1.png]
Gate circuit


To read the true voltage of each motor phase it needs to be compared to the motor's ground. I can recreate that circuit with a set of resistors to create a virtual ground.

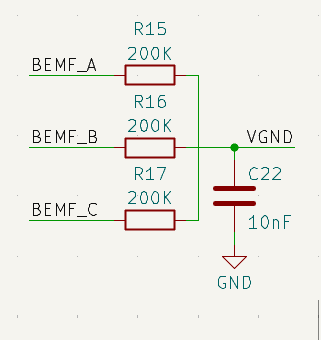
[picture p18: images/vgnd_circuit-1.png]
Virtual ground circuit


**Total time spent: 3 hours**

# October 15: Added overvoltage protection and bulk capacitance

The circuit needs a lot of capacitance to smooth out the noisy switching of the gates and the feedback of the motor. I found online that a good rule of thumb is about 20uF per 1A which puts me at roughly 600uF for 30A. It is also good to have some electrolytic capacitors with high capacitance for low frequency ripples and ceramic capacitors with low capacitance for high frequency ripples. For my design I have two 270uF electrolytic capacitors and six 10uF ceramic capacitors for a total of 600uF.

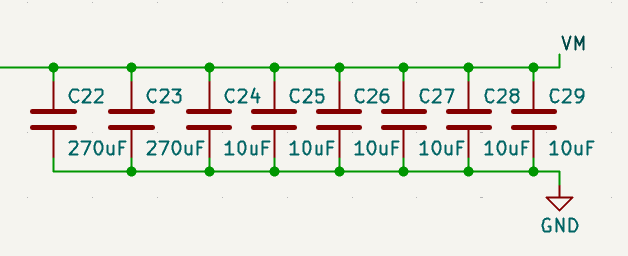
[picture p19: images/driver_bank-1.png]
Driver capacitor bank


I also added one 1000uF capacitor that will be soldered on externally on the battery leads for extra capacitance for the entire board. There is also another TVS diode to prevent overvoltage.

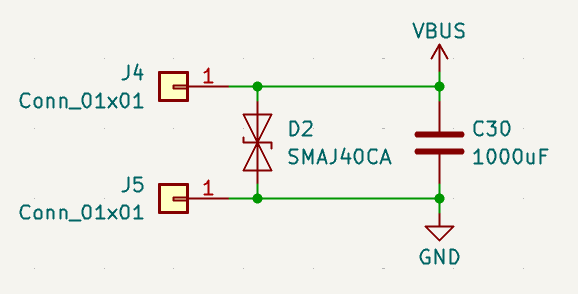
[picture p20: images/global_bank-1.png]
Global capacitor bank


I decided to add extra overvoltage protection on the analog lines with some barrier diodes.

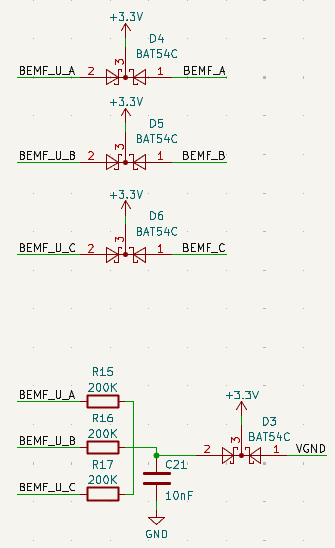
[picture p21: images/analog-circiut-1.png]
Analog circuit


**Total time spent: 2 hours**

# October 19: Selected footprints and made regulator layout

### Selecting footprints

To start the pcb layout I selected footprints for all the components. I had to do a little digging to find the right footprint for the mosfets but I found the right one eventually. The rest was pretty straightforward.

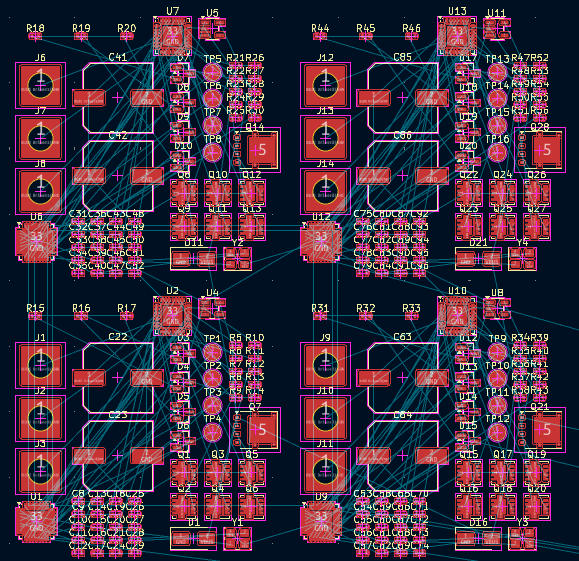
[picture p22: images/footprints-1.png]
Footprints


### Regulator layout

I started making the pdb layout with the regulator. I noticed that I had the wrong footprint for the ic so I went and fixed that and finished it up. 

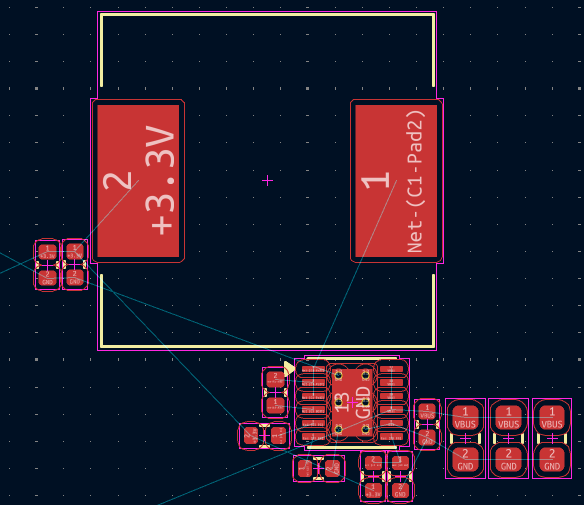
[picture p23: images/reg_layout-1.png]
Regulator layout


**Total time spent: 2 hours**

# October 23: Made driver layout

I started to make the layout for one of the driver circuits. I started with the mcu and added all the caps and the crystal. I then did the same for the gate driver. Next I set up the layout for the mosfets. I had to edit the pin numbers to mach the symbol for the mosfets. Then I took the individual circuits and placed them as close together as I could. I was able to wrap the bulk capacitance around the top of the layout. I also changed the barrier diodes to ones with a smaller package so they would fit better since there are so many of them. The test points will go on the back side of the board but I think I will hold off on placing them until I route it to find a good spot without vias.

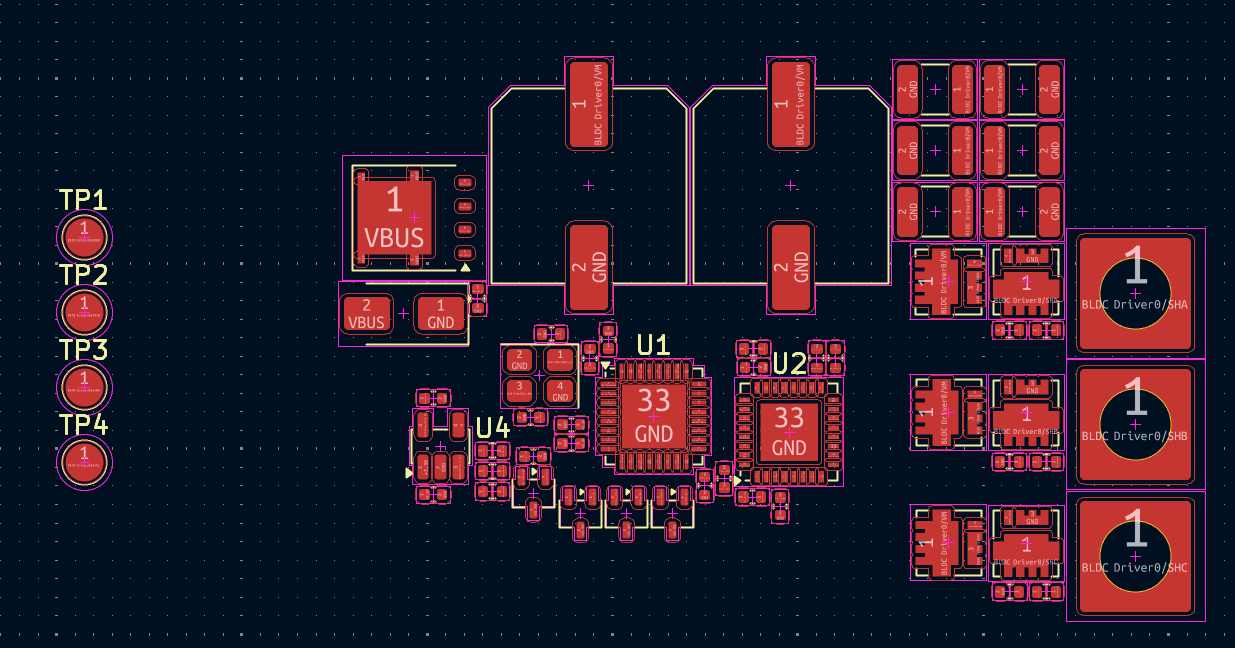
[picture p24: images/driver_layout-1.png]
Driver layout


**Total time spent: 2 hours**

# October 26: Made second driver layout

I don't have much to say here, I just copied the layout I made previously for the next one. I think I will stop and first route one of the drivers to iorn out any layout adjustments next.

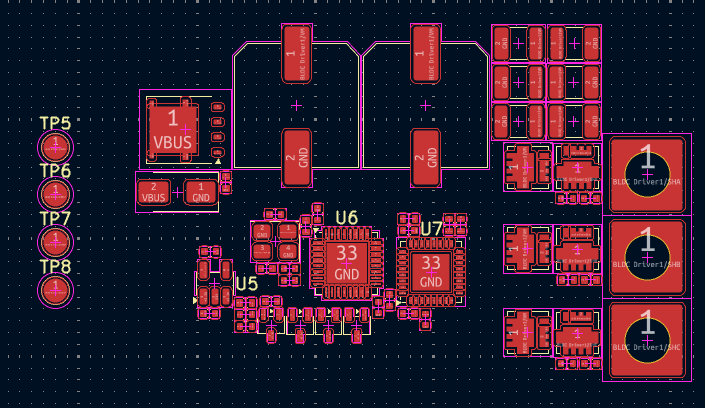
[picture p25: images/driver_layout-2.png]
Driver layout 2


**Total time spent: 1.5 hours**

# October 26: Routed driver

I routed one of the drivers. I started with mcu and gate driver which was pretty simple. When wiring the mcu to the gate driver I noticed that I didn't wire up the gate driver enable and fault pins. I also had to go into STM32CubeMX and configure the mcu pins. I then routed up all the analog measuring components. Next I routed up the regulator. Then I added zone fills for the power traces to allow plenty of current through. For some reason the zone fills wouldn't connect to the mosfet footprints so I had to go and fix each footprint so that it would work with the fills. I added the rest of the fills as well as the gate pin traces and power traces. I think I might remove the top two bulk ceramic capacitors because it makes the power trace stick out so much, but I will try to fit it as it is first.

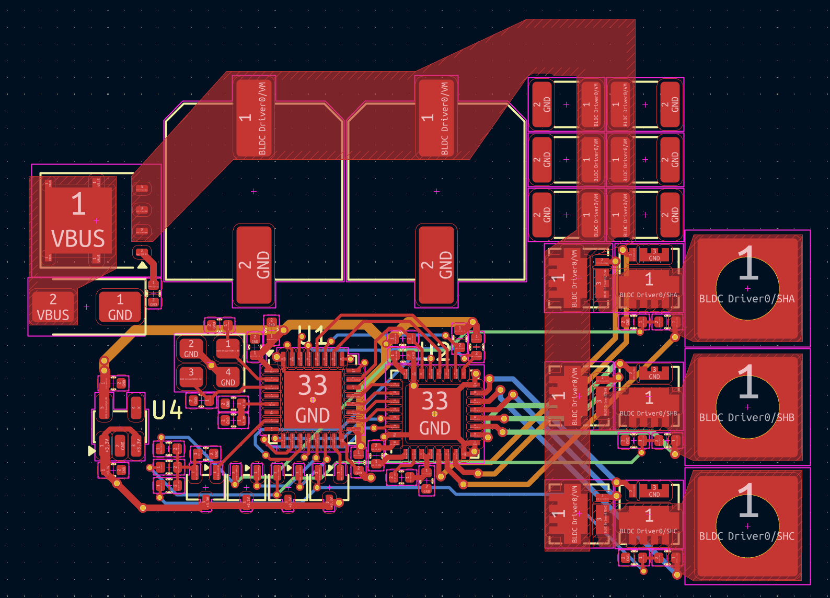
[picture p26: images/driver_pcb-1.png]
Driver PCB


**Total time spent: 2 hours**

# October 27: Finished driver layout

I don't have much to say here either, I just took some time to copy the layout of the other drivers.

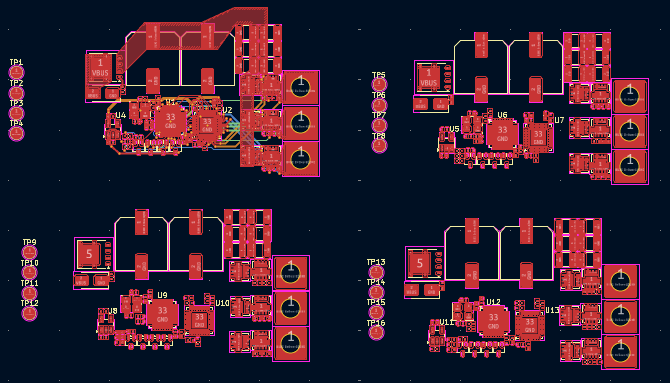
[picture p27: images/driver_layout-3.png]
Full driver layout


**Total time spent: 2 hours**

# October 30: Routed drivers

I routed the other three drivers. I kept it mostly the same but I'd like to think I made some improvements. It just took some time especially since I had to edit all the mosfet footprints to make the copper fills to work.

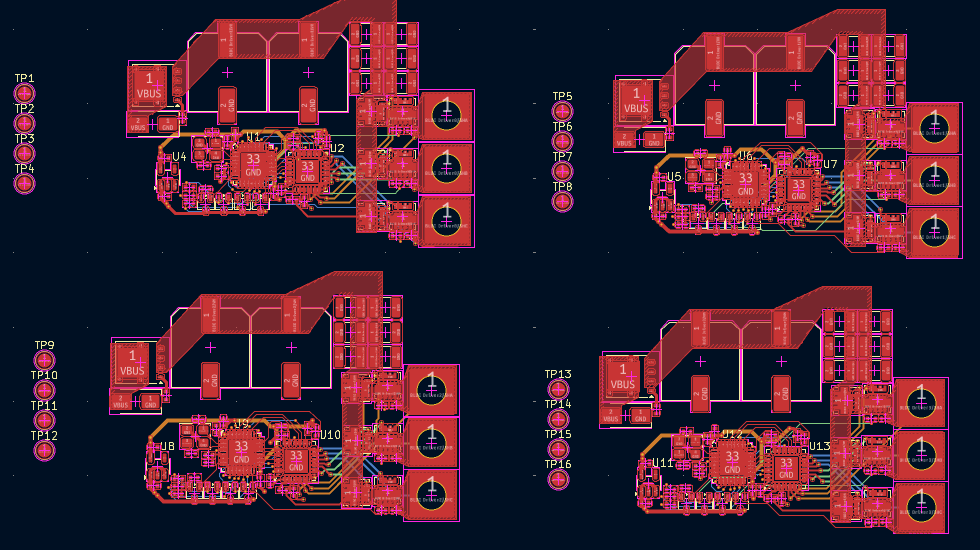
[picture p28: images/driver_pcb-2.png]
Full driver layout


**Total time spent: 4 hours**

# November 9: Finished routing

I placed all the drivers in the corners and placed the other circuits in the middle. I started by making the caps for the regulators 0603 rather than 0402. I had to adjust their position too. I then routed up all the I2C and PWM lines to each of the drivers to the external headers. Then I added zone fills for the 3.3v regulator. I added vias for the 3.3v traces and routed it to each of the drivers. I then routed the boot button to each of the drivers. I then added a large copper fill for vbus and added vias to each of the drivers. To finish I added plenty of ground vias to all of the high power capacitors and mosfets.

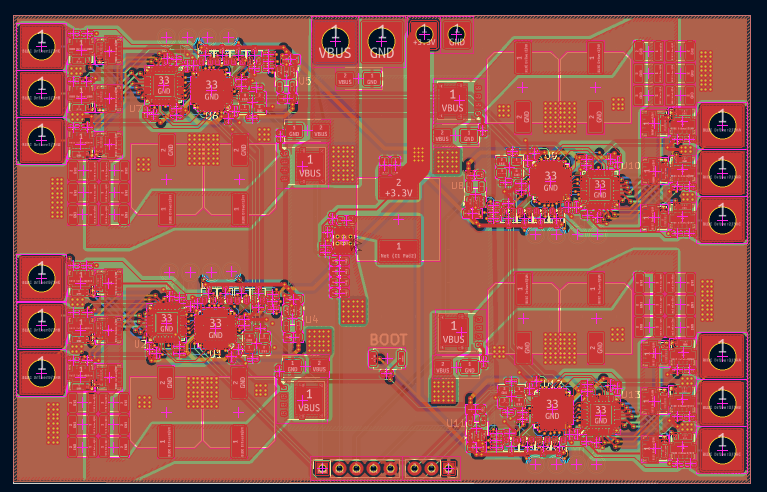
[picture p29: images/pcb-1.png]
Full PCB


**Total time spent: 4 hours**

# November 9: Changed file structure and wrote firmware

Alongside the change to my other forge project I changed the file structure to move the kicad files into hardware/. I generated the basic code with STM32CubeMX and copied my previous ESC firmware from [my other ESC project](https://github.com/someonelse20/ESC). I had to change the pinouts and I found a bug that it didn't properly read the input PWM so I fixed that too. Currently the firmware doesn't communicate with the gate driver over SPI which I don't really need to because it would only be to change the driver's settings and the defaults are fine. It also doesn't use the I2C connection but I will add that later. Here's a picture of the new file structure because pictures of code are boring.

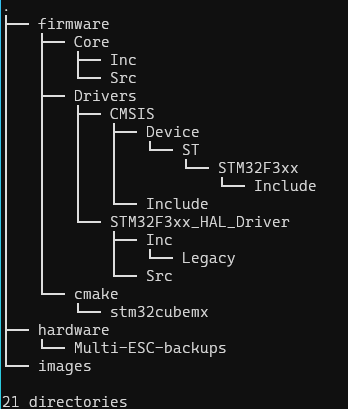
[picture p30: images/file_structure.png]
File structure


**Total time spent: 1.5 hours**

# November 10: Got project ready to ship

I'm about done with the hardware and firmware so I started to get it ready to ship. I started by editing the kicad BOM to add in the specific parts numbers. I changed the footprint for the 10uF capacitors for the 3.3v to be the same for the bulk capacitance of the drivers. This way I have a smaller part count and they are rated for a higher voltage. There still are a few smaller caps connected to the gate driver ic that are rated for 25v when I was shooting for 35v. This is still acceptable but I would have to change the footprint to get caps for a higher voltage. I still might do this later. I moved on and wrote up a readme. Now I think it's ready to go!

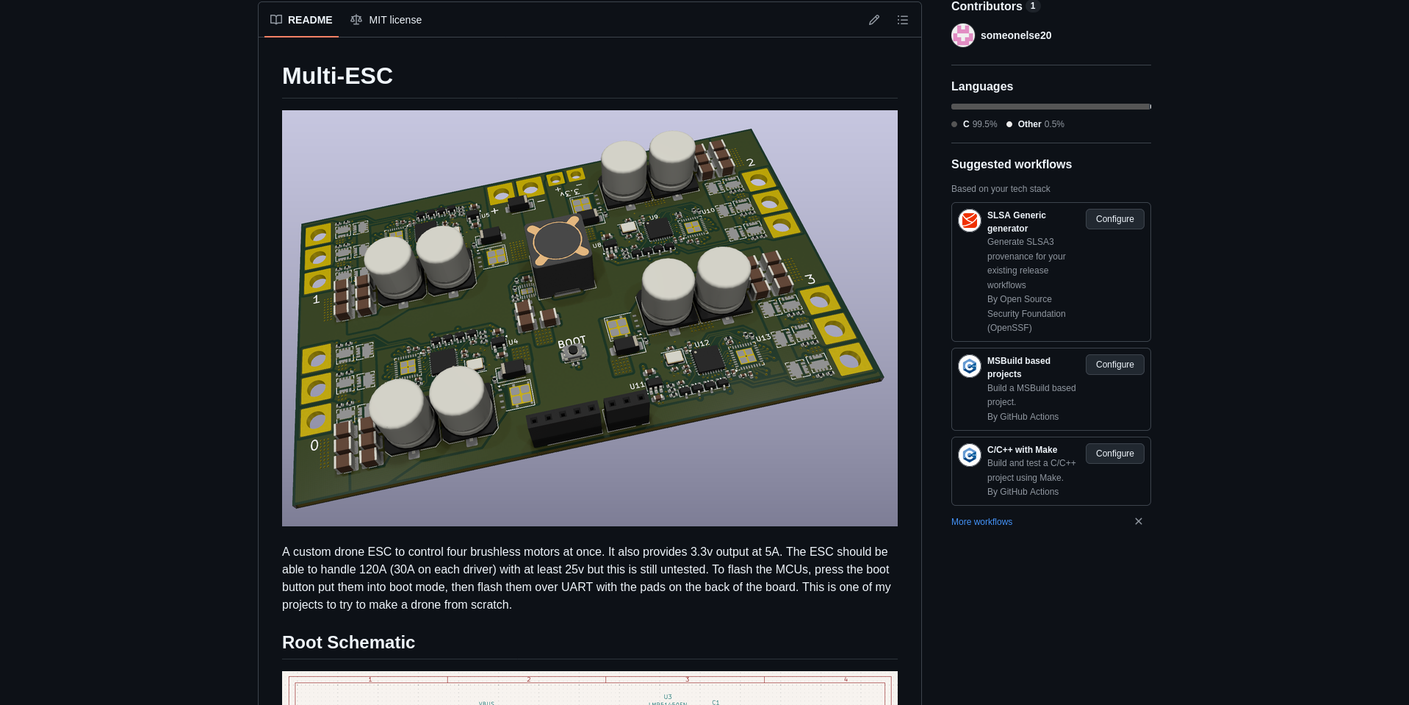
[picture p31: images/readme-1.png]
Readme


**Total time spent: 2 hours**
