someonelse20/Multi-ESC/hardware/Multi-ESC.kicad_pcb

## KiCad design hardware/Multi-ESC.kicad_pcb (2026-11-10)

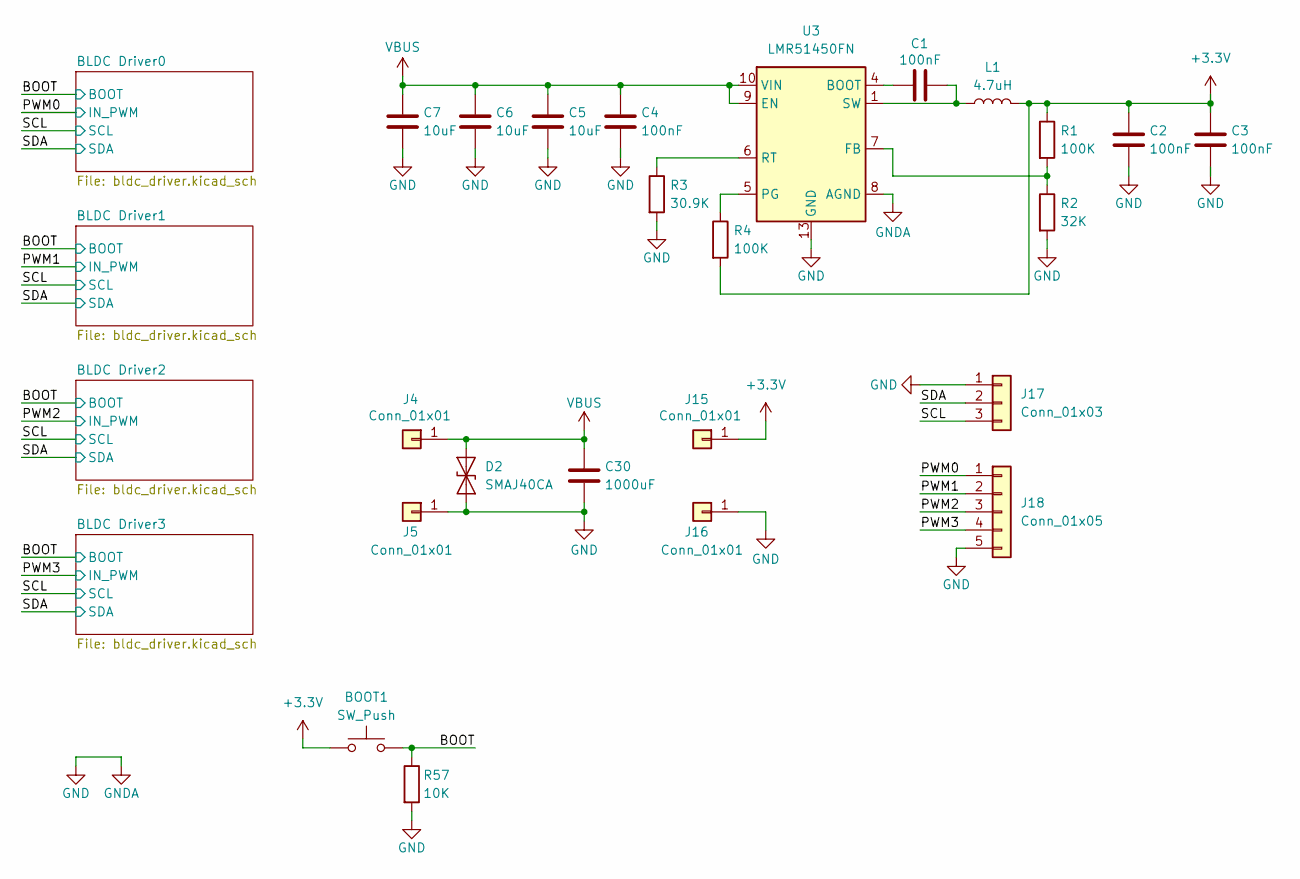
[picture p32: schematic Multi-ESC.kicad_sch]

Parts:
BOOT1: SW_Push; SW_Push_SPST_NO_Alps_SKRK; MPN SKRKAEE020
C1, C2, C3, C4: 100nF; C_0603_1608Metric; MPN C0603C104K5RACTU
C5, C6, C7: 10uF; C_1210_3225Metric; MPN CL32B106KBJNNNE
C30: 1000uF; MPN 35PX1000MEFC10X20
D2: SMAJ40CA; D_SMA; MPN SMAJ40CA
J4, J5: Conn_01x01; SolderWire-4sqmm_1x01_D3mm_OD6mm
J15, J16: Conn_01x01; SolderWire-2sqmm_1x01_D2mm_OD3.9mm
J17: Conn_01x03; PinSocket_1x03_P2.54mm_Vertical
J18: Conn_01x05; PinSocket_1x05_P2.54mm_Vertical
L1: 4.7uH; L_Pulse_PA4320; MPN CDRH127NP-4R7NC
R1, R4: 100K; R_0402_1005Metric; MPN ERJ-2GEJ104X
R2: 32K; R_0402_1005Metric; MPN RN73R1ETTP3202B25
R3: 30.9K; R_0402_1005Metric; MPN RC0402FR-0730K9L
R57: 10K; R_0402_1005Metric; MPN RMCF0402FT10K0
U3: LMR51450FN; WSON-12-1EP_3x3mm_P0.5mm_EP1.5x2.5mm_ThermalVias; MPN LMR51450FNDRRR

Connections:
+3.3V: BOOT1.1, C2.1, C3.1, J15.1 (Pin_1_1), L1.2, R1.1, R4.2; also elsewhere on the board
/BOOT: BOOT1.2, R57.1; also elsewhere on the board
/PWM0: J18.1; also elsewhere on the board
/PWM1: J18.2; also elsewhere on the board
/PWM2: J18.3; also elsewhere on the board
/PWM3: J18.4; also elsewhere on the board
/SCL: J17.3; also elsewhere on the board
/SDA: J17.2; also elsewhere on the board
GND: C2.2, C3.2, C4.2, C5.2, C6.2, C7.2, C30.2, D2.1 (A1), J5.1 (Pin_1_1), J16.1 (Pin_1_1), J17.1, J18.5, R2.2, R3.2, R57.2, U3.8 (AGND), U3.13 (GND); also elsewhere on the board
unnamed: C1.2, L1.1, U3.1 (SW), U3.2 (SW), U3.3 (SW)
unnamed: C1.1, U3.4 (BOOT)
unnamed: R1.2, R2.1, U3.7 (FB)
unnamed: R4.1, U3.5 (PG)
unnamed: R3.1, U3.6 (RT)
VBUS: C4.1, C5.1, C6.1, C7.1, C30.1, D2.2 (A2), J4.1 (Pin_1_1), U3.9 (EN), U3.10 (VIN), U3.11 (VIN), U3.12 (VIN); also elsewhere on the board

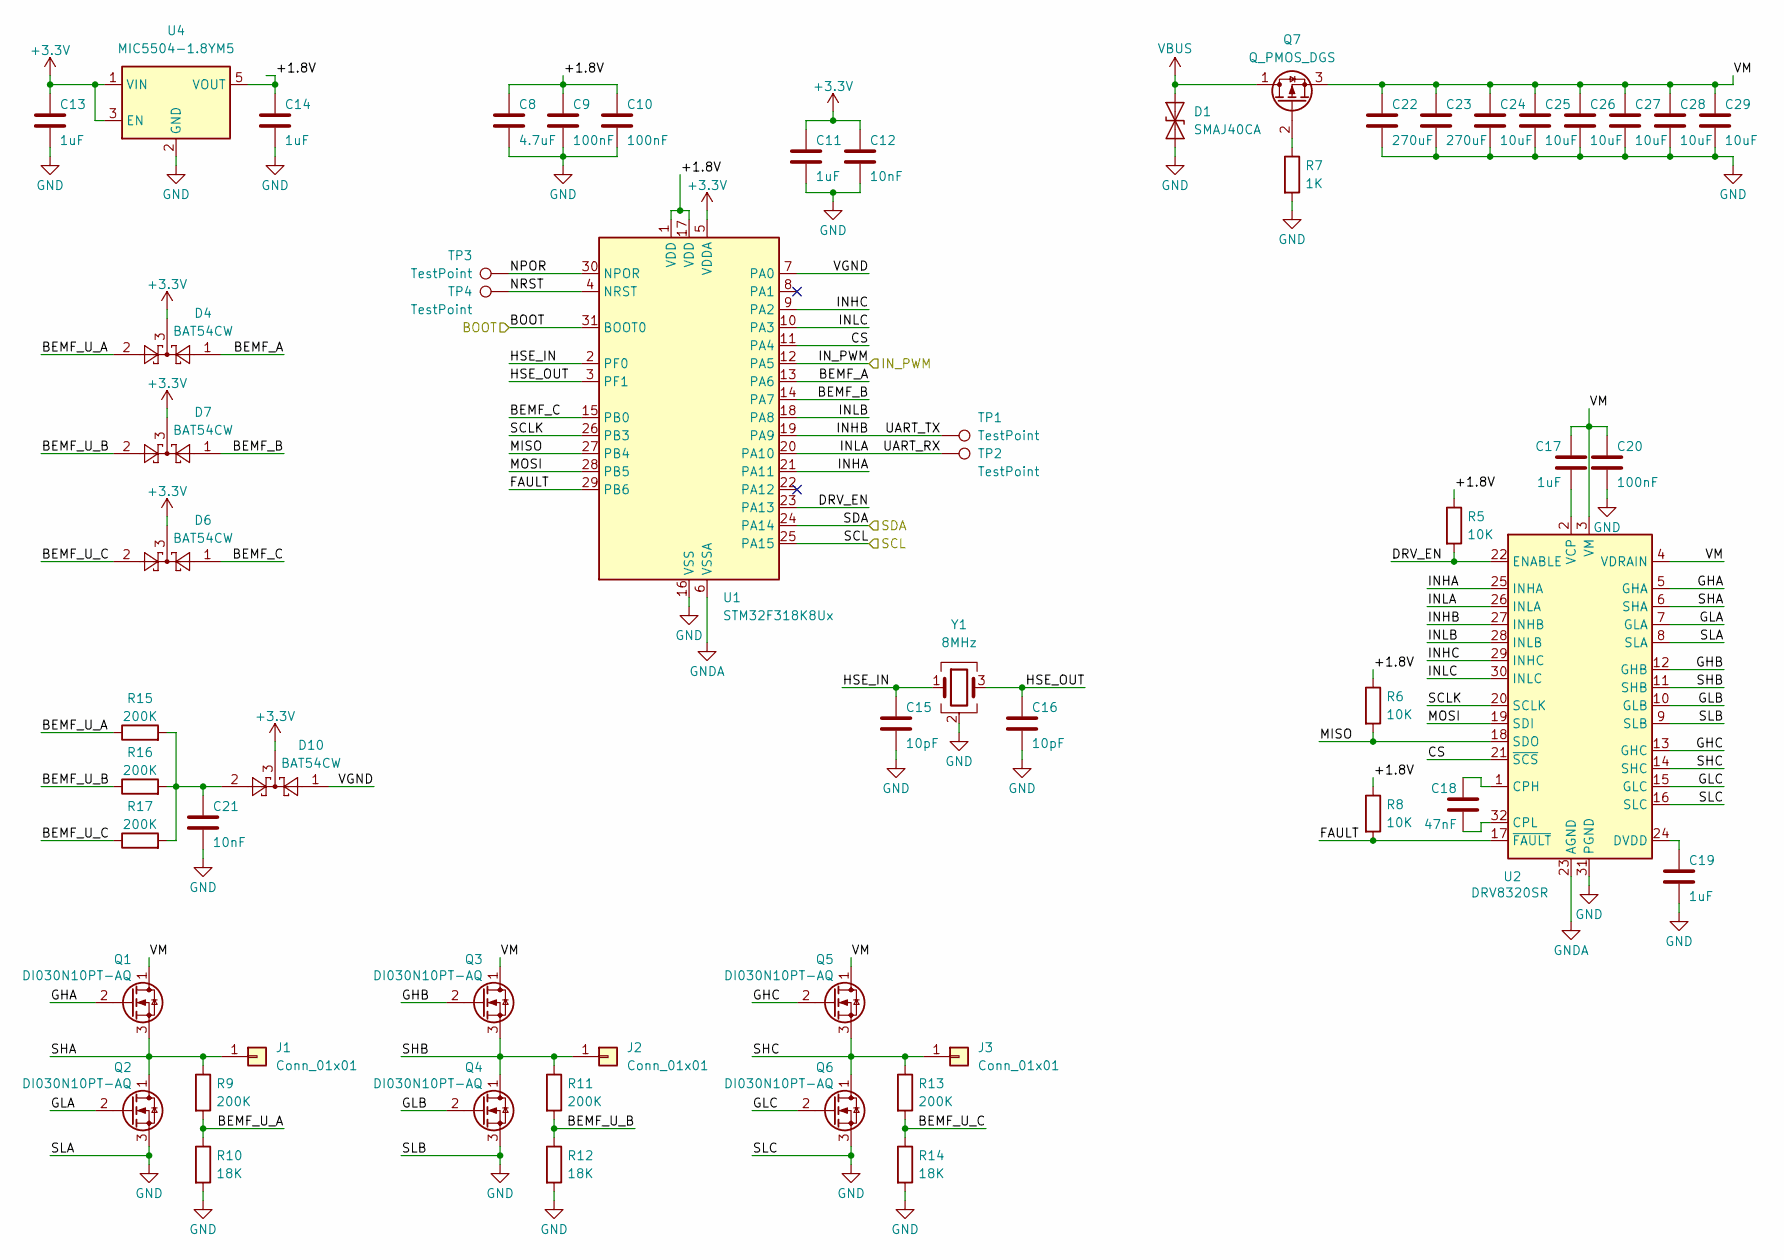
[picture p33: schematic bldc_driver.kicad_sch]

Parts:
C8: 4.7uF; C_0402_1005Metric; MPN CL05A475MO5NUNC
C9, C10, C20: 100nF; C_0402_1005Metric; MPN GCM155R71H104KE02D
C11, C17, C19: 1uF; C_0402_1005Metric; MPN CL05A105KA5NQNC
C12, C21: 10nF; C_0402_1005Metric; MPN GCM155R71H103KA55D
C13, C14: 1uF; C_0603_1608Metric; MPN UMK107AB7105KA-T
C15, C16: 10pF; C_0402_1005Metric; MPN GRM1555C1H100FA01D
C18: 47nF; C_0402_1005Metric; MPN GRM155R71H473KE14D
C22, C23: 270uF; C_Elec_10x10.2; MPN A768MS277M1GLAE022
C24, C25, C26, C27, C28, C29: 10uF; C_1210_3225Metric; MPN CL32B106KBJNNNE
D1: SMAJ40CA; D_SMA; MPN SMAJ40CA
D4, D6, D7, D10: BAT54CW; SOT-323_SC-70; MPN BAT54CW
J1, J2, J3: Conn_01x01; SolderWire-4sqmm_1x01_D3mm_OD6mm
Q1, Q2, Q3, Q4, Q5, Q6: DI030N10PT-AQ; D_QFN_3.3x3.3mm_P0.65mm; MPN DI030N10PT-AQ
Q7: Q_PMOS_DGS; PowerPAK_SO-8L_Single; MPN SQJ457EP-T1_GE3
R5, R6, R8: 10K; R_0402_1005Metric; MPN RMCF0402FT10K0
R7: 1K; R_0402_1005Metric; MPN ERJ-2RKF1001X
R9, R11, R13, R15, R16, R17: 200K; R_0402_1005Metric; MPN RC0402FR-07200KL
R10, R12, R14: 18K; R_0402_1005Metric; MPN RC0402FR-0718KL
TP1, TP2, TP3, TP4: TestPoint; TestPoint_Pad_D2.0mm
U1: STM32F318K8Ux; QFN-32-1EP_5x5mm_P0.5mm_EP3.45x3.45mm; MPN STM32F318K8U6
U2: DRV8320SR; WQFN-32-1EP_5x5mm_P0.5mm_EP3.1x3.1mm; MPN DRV8320SRTVR
U4: MIC5504-1.8YM5; SOT-23-5; MPN MIC5504-1.8YM5-TR
Y1: 8MHz; Crystal_SMD_3225-4Pin_3.2x2.5mm; MPN ECS-80-8-33Q-ADS

Connections:
+3.3V: C11.1, C12.1, C13.1, D4.3, D6.3, D7.3, D10.3, U1.5 (VDDA), U4.1 (VIN), U4.3 (EN); also elsewhere on the board
/BLDC Driver0/+1.8V: C8.1, C9.1, C10.1, C14.1, R5.1, R6.1, R8.1, U1.1 (VDD), U1.17 (VDD), U4.5 (VOUT)
/BLDC Driver0/BEMF_A: D4.1, U1.13 (PA6)
/BLDC Driver0/BEMF_B: D7.1, U1.14 (PA7)
/BLDC Driver0/BEMF_C: D6.1, U1.15 (PB0)
/BLDC Driver0/BEMF_U_A: D4.2, R9.2, R10.1, R15.1
/BLDC Driver0/BEMF_U_B: D7.2, R11.2, R12.1, R16.1
/BLDC Driver0/BEMF_U_C: D6.2, R13.2, R14.1, R17.1
/BLDC Driver0/CS: U1.11 (PA4), U2.21 (~SCS)
/BLDC Driver0/DRV_EN: R5.2, U1.23 (PA13), U2.22 (ENABLE)
/BLDC Driver0/FAULT: R8.2, U1.29 (PB6), U2.17 (~FAULT)
/BLDC Driver0/GHA: Q1.2 (G), U2.5 (GHA)
/BLDC Driver0/GHB: Q3.2 (G), U2.12 (GHB)
/BLDC Driver0/GHC: Q5.2 (G), U2.13 (GHC)
/BLDC Driver0/GLA: Q2.2 (G), U2.7 (GLA)
/BLDC Driver0/GLB: Q4.2 (G), U2.10 (GLB)
/BLDC Driver0/GLC: Q6.2 (G), U2.15 (GLC)
/BLDC Driver0/HSE_IN: C15.1, U1.2 (PF0), Y1.1
/BLDC Driver0/HSE_OUT: C16.1, U1.3 (PF1), Y1.3
/BLDC Driver0/INHA: U1.21 (PA11), U2.25 (INHA)
/BLDC Driver0/INHB: TP1.1 (1_1), U1.19 (PA9), U2.27 (INHB)
/BLDC Driver0/INHC: U1.9 (PA2), U2.29 (INHC)
/BLDC Driver0/INLA: TP2.1 (1_1), U1.20 (PA10), U2.26 (INLA)
/BLDC Driver0/INLB: U1.18 (PA8), U2.28 (INLB)
/BLDC Driver0/INLC: U1.10 (PA3), U2.30 (INLC)
/BLDC Driver0/MISO: R6.2, U1.27 (PB4), U2.18 (SDO)
/BLDC Driver0/MOSI: U1.28 (PB5), U2.19 (SDI)
/BLDC Driver0/NPOR: TP3.1 (1_1), U1.30 (NPOR)
/BLDC Driver0/NRST: TP4.1 (1_1), U1.4 (NRST)
/BLDC Driver0/SCLK: U1.26 (PB3), U2.20 (SCLK)
/BLDC Driver0/SHA: J1.1 (Pin_1_1), Q1.3 (S), Q2.1 (D), R9.1, U2.6 (SHA)
/BLDC Driver0/SHB: J2.1 (Pin_1_1), Q3.3 (S), Q4.1 (D), R11.1, U2.11 (SHB)
/BLDC Driver0/SHC: J3.1 (Pin_1_1), Q5.3 (S), Q6.1 (D), R13.1, U2.14 (SHC)
/BLDC Driver0/VGND: D10.1, U1.7 (PA0)
/BLDC Driver0/VM: C17.1, C20.1, C22.1, C23.1, C24.1, C25.1, C26.1, C27.1, C28.1, C29.1, Q1.1 (D), Q3.1 (D), Q5.1 (D), Q7.3 (S), U2.3 (VM), U2.4 (VDRAIN)
/BOOT: U1.31 (BOOT0); also elsewhere on the board
/PWM0: U1.12 (PA5); also elsewhere on the board
/SCL: U1.25 (PA15); also elsewhere on the board
/SDA: U1.24 (PA14); also elsewhere on the board
GND: C8.2, C9.2, C10.2, C11.2, C12.2, C13.2, C14.2, C15.2, C16.2, C19.2, C20.2, C21.2, C22.2, C23.2, C24.2, C25.2, C26.2, C27.2, C28.2, C29.2, D1.1 (A1), Q2.3 (S), Q4.3 (S), Q6.3 (S), R7.2, R10.2, R12.2, R14.2, U1.6 (VSSA), U1.16 (VSS), U1.32 (VSS), U1.33 (VSS), U2.8 (SLA), U2.9 (SLB), U2.16 (SLC), U2.23 (AGND), U2.31 (PGND), U2.33 (PGND), U4.2 (GND), Y1.2 (G), Y1.4 (G); also elsewhere on the board
unnamed: C21.1, D10.2, R15.2, R16.2, R17.2
unnamed: Q7.2 (G), R7.1
unnamed: C18.1, U2.1 (CPH)
unnamed: C18.2, U2.32 (CPL)
unnamed: C19.1, U2.24 (DVDD)
unnamed: C17.2, U2.2 (VCP)
VBUS: D1.2 (A2), Q7.1 (D); also elsewhere on the board

Parts of its further copies:
C31, C33, C53, C55, C75, C77: 1uF; C_0603_1608Metric; MPN UMK107AB7105KA-T
C32, C38, C54, C60, C76, C82: 10nF; C_0402_1005Metric; MPN GCM155R71H103KA55D
C34, C56, C78: 4.7uF; C_0402_1005Metric; MPN CL05A475MO5NUNC
C35, C36, C48, C57, C58, C70, C79, C80, C92: 100nF; C_0402_1005Metric; MPN GCM155R71H104KE02D
C37, C46, C51, C59, C68, C73, C81, C90, C95: 1uF; C_0402_1005Metric; MPN CL05A105KA5NQNC
C39, C40, C61, C62, C83, C84: 10pF; C_0402_1005Metric; MPN GRM1555C1H100FA01D
C41, C42, C63, C64, C85, C86: 270uF; C_Elec_10x10.2; MPN A768MS277M1GLAE022
C43, C65, C87: 47nF; C_0402_1005Metric; MPN GRM155R71H473KE14D
C44, C45, C47, C49, C50, C52, C66, C67, C69, C71, C72, C74, C88, C89, C91, C93, C94, C96: 10uF; C_1210_3225Metric; MPN CL32B106KBJNNNE
D8, D9, D12, D13, D14, D15, D17, D18, D19, D23, D24, D25: BAT54CW; SOT-323_SC-70; MPN BAT54CW
D11, D16, D21: SMAJ40CA; D_SMA; MPN SMAJ40CA
J6, J7, J8, J9, J10, J11, J12, J13, J14: Conn_01x01; SolderWire-4sqmm_1x01_D3mm_OD6mm
Q8, Q9, Q10, Q11, Q12, Q13, Q15, Q16, Q17, Q18, Q19, Q20, Q22, Q23, Q24, Q25, Q26, Q27: DI030N10PT-AQ; D_QFN_3.3x3.3mm_P0.65mm; MPN DI030N10PT-AQ
Q14, Q21, Q28: Q_PMOS_DGS; PowerPAK_SO-8L_Single; MPN SQJ457EP-T1_GE3
R18, R19, R20, R21, R23, R25, R31, R32, R33, R34, R36, R38, R44, R45, R46, R47, R49, R51: 200K; R_0402_1005Metric; MPN RC0402FR-07200KL
R22, R24, R26, R35, R37, R39, R48, R50, R52: 18K; R_0402_1005Metric; MPN RC0402FR-0718KL
R27, R40, R53: 1K; R_0402_1005Metric; MPN ERJ-2RKF1001X
R28, R29, R30, R41, R42, R43, R54, R55, R56: 10K; R_0402_1005Metric; MPN RMCF0402FT10K0
TP5, TP6, TP7, TP8, TP9, TP10, TP11, TP12, TP13, TP14, TP15, TP16: TestPoint; TestPoint_Pad_D2.0mm
U5, U8, U11: MIC5504-1.8YM5; SOT-23-5; MPN MIC5504-1.8YM5-TR
U6, U9, U12: STM32F318K8Ux; QFN-32-1EP_5x5mm_P0.5mm_EP3.45x3.45mm; MPN STM32F318K8U6
U7, U10, U13: DRV8320SR; WQFN-32-1EP_5x5mm_P0.5mm_EP3.1x3.1mm; MPN DRV8320SRTVR
Y2, Y3, Y4: 8MHz; Crystal_SMD_3225-4Pin_3.2x2.5mm; MPN ECS-80-8-33Q-ADS

Connections of its further copies:
+3.3V: C31.1, C37.1, C38.1, C53.1, C59.1, C60.1, C75.1, C81.1, C82.1, D8.3, D9.3, D12.3, D13.3, D14.3, D15.3, D17.3, D18.3, D19.3, D23.3, D24.3, D25.3, U5.1 (VIN), U5.3 (EN), U6.5 (VDDA), U8.1 (VIN), U8.3 (EN), U9.5 (VDDA), U11.1 (VIN), U11.3 (EN), U12.5 (VDDA); also elsewhere on the board
/BLDC Driver1/+1.8V: C33.1, C34.1, C35.1, C36.1, R28.1, R29.1, R30.1, U5.5 (VOUT), U6.1 (VDD), U6.17 (VDD)
/BLDC Driver1/BEMF_A: D23.1, U6.13 (PA6)
/BLDC Driver1/BEMF_B: D8.1, U6.14 (PA7)
/BLDC Driver1/BEMF_C: D12.1, U6.15 (PB0)
/BLDC Driver1/BEMF_U_A: D23.2, R18.1, R21.2, R22.1
/BLDC Driver1/BEMF_U_B: D8.2, R19.1, R23.2, R24.1
/BLDC Driver1/BEMF_U_C: D12.2, R20.1, R25.2, R26.1
/BLDC Driver1/CS: U6.11 (PA4), U7.21 (~SCS)
/BLDC Driver1/DRV_EN: R30.2, U6.23 (PA13), U7.22 (ENABLE)
/BLDC Driver1/FAULT: R29.2, U6.29 (PB6), U7.17 (~FAULT)
/BLDC Driver1/GHA: Q8.2 (G), U7.5 (GHA)
/BLDC Driver1/GHB: Q10.2 (G), U7.12 (GHB)
/BLDC Driver1/GHC: Q12.2 (G), U7.13 (GHC)
/BLDC Driver1/GLA: Q9.2 (G), U7.7 (GLA)
/BLDC Driver1/GLB: Q11.2 (G), U7.10 (GLB)
/BLDC Driver1/GLC: Q13.2 (G), U7.15 (GLC)
/BLDC Driver1/HSE_IN: C39.1, U6.2 (PF0), Y2.1
/BLDC Driver1/HSE_OUT: C40.1, U6.3 (PF1), Y2.3
/BLDC Driver1/INHA: U6.21 (PA11), U7.25 (INHA)
/BLDC Driver1/INHB: TP7.1 (1_1), U6.19 (PA9), U7.27 (INHB)
/BLDC Driver1/INHC: U6.9 (PA2), U7.29 (INHC)
/BLDC Driver1/INLA: TP8.1 (1_1), U6.20 (PA10), U7.26 (INLA)
/BLDC Driver1/INLB: U6.18 (PA8), U7.28 (INLB)
/BLDC Driver1/INLC: U6.10 (PA3), U7.30 (INLC)
/BLDC Driver1/MISO: R28.2, U6.27 (PB4), U7.18 (SDO)
/BLDC Driver1/MOSI: U6.28 (PB5), U7.19 (SDI)
/BLDC Driver1/NPOR: TP5.1 (1_1), U6.30 (NPOR)
/BLDC Driver1/NRST: TP6.1 (1_1), U6.4 (NRST)
/BLDC Driver1/SCLK: U6.26 (PB3), U7.20 (SCLK)
/BLDC Driver1/SHA: J6.1 (Pin_1_1), Q8.3 (S), Q9.1 (D), R21.1, U7.6 (SHA)
/BLDC Driver1/SHB: J7.1 (Pin_1_1), Q10.3 (S), Q11.1 (D), R23.1, U7.11 (SHB)
/BLDC Driver1/SHC: J8.1 (Pin_1_1), Q12.3 (S), Q13.1 (D), R25.1, U7.14 (SHC)
/BLDC Driver1/VGND: D15.1, U6.7 (PA0)
/BLDC Driver1/VM: C41.1, C42.1, C44.1, C45.1, C46.1, C47.1, C48.1, C49.1, C50.1, C52.1, Q8.1 (D), Q10.1 (D), Q12.1 (D), Q14.3 (S), U7.3 (VM), U7.4 (VDRAIN)
/BLDC Driver2/+1.8V: C55.1, C56.1, C57.1, C58.1, R41.1, R42.1, R43.1, U8.5 (VOUT), U9.1 (VDD), U9.17 (VDD)
/BLDC Driver2/BEMF_A: D24.1, U9.13 (PA6)
/BLDC Driver2/BEMF_B: D9.1, U9.14 (PA7)
/BLDC Driver2/BEMF_C: D13.1, U9.15 (PB0)
/BLDC Driver2/BEMF_U_A: D24.2, R31.1, R34.2, R35.1
/BLDC Driver2/BEMF_U_B: D9.2, R32.1, R36.2, R37.1
/BLDC Driver2/BEMF_U_C: D13.2, R33.1, R38.2, R39.1
/BLDC Driver2/CS: U9.11 (PA4), U10.21 (~SCS)
/BLDC Driver2/DRV_EN: R43.2, U9.23 (PA13), U10.22 (ENABLE)
/BLDC Driver2/FAULT: R42.2, U9.29 (PB6), U10.17 (~FAULT)
/BLDC Driver2/GHA: Q15.2 (G), U10.5 (GHA)
/BLDC Driver2/GHB: Q17.2 (G), U10.12 (GHB)
/BLDC Driver2/GHC: Q19.2 (G), U10.13 (GHC)
/BLDC Driver2/GLA: Q16.2 (G), U10.7 (GLA)
/BLDC Driver2/GLB: Q18.2 (G), U10.10 (GLB)
/BLDC Driver2/GLC: Q20.2 (G), U10.15 (GLC)
/BLDC Driver2/HSE_IN: C61.1, U9.2 (PF0), Y3.1
/BLDC Driver2/HSE_OUT: C62.1, U9.3 (PF1), Y3.3
/BLDC Driver2/INHA: U9.21 (PA11), U10.25 (INHA)
/BLDC Driver2/INHB: TP11.1 (1_1), U9.19 (PA9), U10.27 (INHB)
/BLDC Driver2/INHC: U9.9 (PA2), U10.29 (INHC)
/BLDC Driver2/INLA: TP12.1 (1_1), U9.20 (PA10), U10.26 (INLA)
/BLDC Driver2/INLB: U9.18 (PA8), U10.28 (INLB)
/BLDC Driver2/INLC: U9.10 (PA3), U10.30 (INLC)
/BLDC Driver2/MISO: R41.2, U9.27 (PB4), U10.18 (SDO)
/BLDC Driver2/MOSI: U9.28 (PB5), U10.19 (SDI)
/BLDC Driver2/NPOR: TP9.1 (1_1), U9.30 (NPOR)
/BLDC Driver2/NRST: TP10.1 (1_1), U9.4 (NRST)
/BLDC Driver2/SCLK: U9.26 (PB3), U10.20 (SCLK)
/BLDC Driver2/SHA: J9.1 (Pin_1_1), Q15.3 (S), Q16.1 (D), R34.1, U10.6 (SHA)
/BLDC Driver2/SHB: J10.1 (Pin_1_1), Q17.3 (S), Q18.1 (D), R36.1, U10.11 (SHB)
/BLDC Driver2/SHC: J11.1 (Pin_1_1), Q19.3 (S), Q20.1 (D), R38.1, U10.14 (SHC)
/BLDC Driver2/VGND: D18.1, U9.7 (PA0)
/BLDC Driver2/VM: C63.1, C64.1, C66.1, C67.1, C68.1, C69.1, C70.1, C71.1, C72.1, C74.1, Q15.1 (D), Q17.1 (D), Q19.1 (D), Q21.3 (S), U10.3 (VM), U10.4 (VDRAIN)
/BLDC Driver3/+1.8V: C77.1, C78.1, C79.1, C80.1, R54.1, R55.1, R56.1, U11.5 (VOUT), U12.1 (VDD), U12.17 (VDD)
/BLDC Driver3/BEMF_A: D25.1, U12.13 (PA6)
/BLDC Driver3/BEMF_B: D17.1, U12.14 (PA7)
/BLDC Driver3/BEMF_C: D14.1, U12.15 (PB0)
/BLDC Driver3/BEMF_U_A: D25.2, R44.1, R47.2, R48.1
/BLDC Driver3/BEMF_U_B: D17.2, R45.1, R49.2, R50.1
/BLDC Driver3/BEMF_U_C: D14.2, R46.1, R51.2, R52.1
/BLDC Driver3/CS: U12.11 (PA4), U13.21 (~SCS)
/BLDC Driver3/DRV_EN: R56.2, U12.23 (PA13), U13.22 (ENABLE)
/BLDC Driver3/FAULT: R55.2, U12.29 (PB6), U13.17 (~FAULT)
/BLDC Driver3/GHA: Q22.2 (G), U13.5 (GHA)
/BLDC Driver3/GHB: Q24.2 (G), U13.12 (GHB)
/BLDC Driver3/GHC: Q26.2 (G), U13.13 (GHC)
/BLDC Driver3/GLA: Q23.2 (G), U13.7 (GLA)
/BLDC Driver3/GLB: Q25.2 (G), U13.10 (GLB)
/BLDC Driver3/GLC: Q27.2 (G), U13.15 (GLC)
/BLDC Driver3/HSE_IN: C83.1, U12.2 (PF0), Y4.1
/BLDC Driver3/HSE_OUT: C84.1, U12.3 (PF1), Y4.3
/BLDC Driver3/INHA: U12.21 (PA11), U13.25 (INHA)
/BLDC Driver3/INHB: TP15.1 (1_1), U12.19 (PA9), U13.27 (INHB)
/BLDC Driver3/INHC: U12.9 (PA2), U13.29 (INHC)
/BLDC Driver3/INLA: TP16.1 (1_1), U12.20 (PA10), U13.26 (INLA)
/BLDC Driver3/INLB: U12.18 (PA8), U13.28 (INLB)
/BLDC Driver3/INLC: U12.10 (PA3), U13.30 (INLC)
/BLDC Driver3/MISO: R54.2, U12.27 (PB4), U13.18 (SDO)
/BLDC Driver3/MOSI: U12.28 (PB5), U13.19 (SDI)
/BLDC Driver3/NPOR: TP13.1 (1_1), U12.30 (NPOR)
/BLDC Driver3/NRST: TP14.1 (1_1), U12.4 (NRST)
/BLDC Driver3/SCLK: U12.26 (PB3), U13.20 (SCLK)
/BLDC Driver3/SHA: J12.1 (Pin_1_1), Q22.3 (S), Q23.1 (D), R47.1, U13.6 (SHA)
/BLDC Driver3/SHB: J13.1 (Pin_1_1), Q24.3 (S), Q25.1 (D), R49.1, U13.11 (SHB)
/BLDC Driver3/SHC: J14.1 (Pin_1_1), Q26.3 (S), Q27.1 (D), R51.1, U13.14 (SHC)
/BLDC Driver3/VGND: D19.1, U12.7 (PA0)
/BLDC Driver3/VM: C85.1, C86.1, C88.1, C89.1, C90.1, C91.1, C92.1, C93.1, C94.1, C96.1, Q22.1 (D), Q24.1 (D), Q26.1 (D), Q28.3 (S), U13.3 (VM), U13.4 (VDRAIN)
/BOOT: U6.31 (BOOT0), U9.31 (BOOT0), U12.31 (BOOT0); also elsewhere on the board
/PWM1: U6.12 (PA5); also elsewhere on the board
/PWM2: U9.12 (PA5); also elsewhere on the board
/PWM3: U12.12 (PA5); also elsewhere on the board
/SCL: U6.25 (PA15), U9.25 (PA15), U12.25 (PA15); also elsewhere on the board
/SDA: U6.24 (PA14), U9.24 (PA14), U12.24 (PA14); also elsewhere on the board
GND: C31.2, C32.2, C33.2, C34.2, C35.2, C36.2, C37.2, C38.2, C39.2, C40.2, C41.2, C42.2, C44.2, C45.2, C47.2, C48.2, C49.2, C50.2, C51.2, C52.2, C53.2, C54.2, C55.2, C56.2, C57.2, C58.2, C59.2, C60.2, C61.2, C62.2, C63.2, C64.2, C66.2, C67.2, C69.2, C70.2, C71.2, C72.2, C73.2, C74.2, C75.2, C76.2, C77.2, C78.2, C79.2, C80.2, C81.2, C82.2, C83.2, C84.2, C85.2, C86.2, C88.2, C89.2, C91.2, C92.2, C93.2, C94.2, C95.2, C96.2, D11.1 (A1), D16.1 (A1), D21.1 (A1), Q9.3 (S), Q11.3 (S), Q13.3 (S), Q16.3 (S), Q18.3 (S), Q20.3 (S), Q23.3 (S), Q25.3 (S), Q27.3 (S), R22.2, R24.2, R26.2, R27.2, R35.2, R37.2, R39.2, R40.2, R48.2, R50.2, R52.2, R53.2, U5.2 (GND), U6.6 (VSSA), U6.16 (VSS), U6.32 (VSS), U6.33 (VSS), U7.8 (SLA), U7.9 (SLB), U7.16 (SLC), U7.23 (AGND), U7.31 (PGND), U7.33 (PGND), U8.2 (GND), U9.6 (VSSA), U9.16 (VSS), U9.32 (VSS), U9.33 (VSS), U10.8 (SLA), U10.9 (SLB), U10.16 (SLC), U10.23 (AGND), U10.31 (PGND), U10.33 (PGND), U11.2 (GND), U12.6 (VSSA), U12.16 (VSS), U12.32 (VSS), U12.33 (VSS), U13.8 (SLA), U13.9 (SLB), U13.16 (SLC), U13.23 (AGND), U13.31 (PGND), U13.33 (PGND), Y2.2 (G), Y2.4 (G), Y3.2 (G), Y3.4 (G), Y4.2 (G), Y4.4 (G); also elsewhere on the board
unnamed: C32.1, D15.2, R18.2, R19.2, R20.2
unnamed: C54.1, D18.2, R31.2, R32.2, R33.2
unnamed: C76.1, D19.2, R44.2, R45.2, R46.2
unnamed: Q14.2 (G), R27.1
unnamed: Q21.2 (G), R40.1
unnamed: Q28.2 (G), R53.1
unnamed: C43.1, U7.1 (CPH)
unnamed: C43.2, U7.32 (CPL)
unnamed: C51.1, U7.24 (DVDD)
unnamed: C46.2, U7.2 (VCP)
unnamed: C65.1, U10.1 (CPH)
unnamed: C65.2, U10.32 (CPL)
unnamed: C73.1, U10.24 (DVDD)
unnamed: C68.2, U10.2 (VCP)
unnamed: C87.1, U13.1 (CPH)
unnamed: C87.2, U13.32 (CPL)
unnamed: C95.1, U13.24 (DVDD)
unnamed: C90.2, U13.2 (VCP)
VBUS: D11.2 (A2), D16.2 (A2), D21.2 (A2), Q14.1 (D), Q21.1 (D), Q28.1 (D); also elsewhere on the board

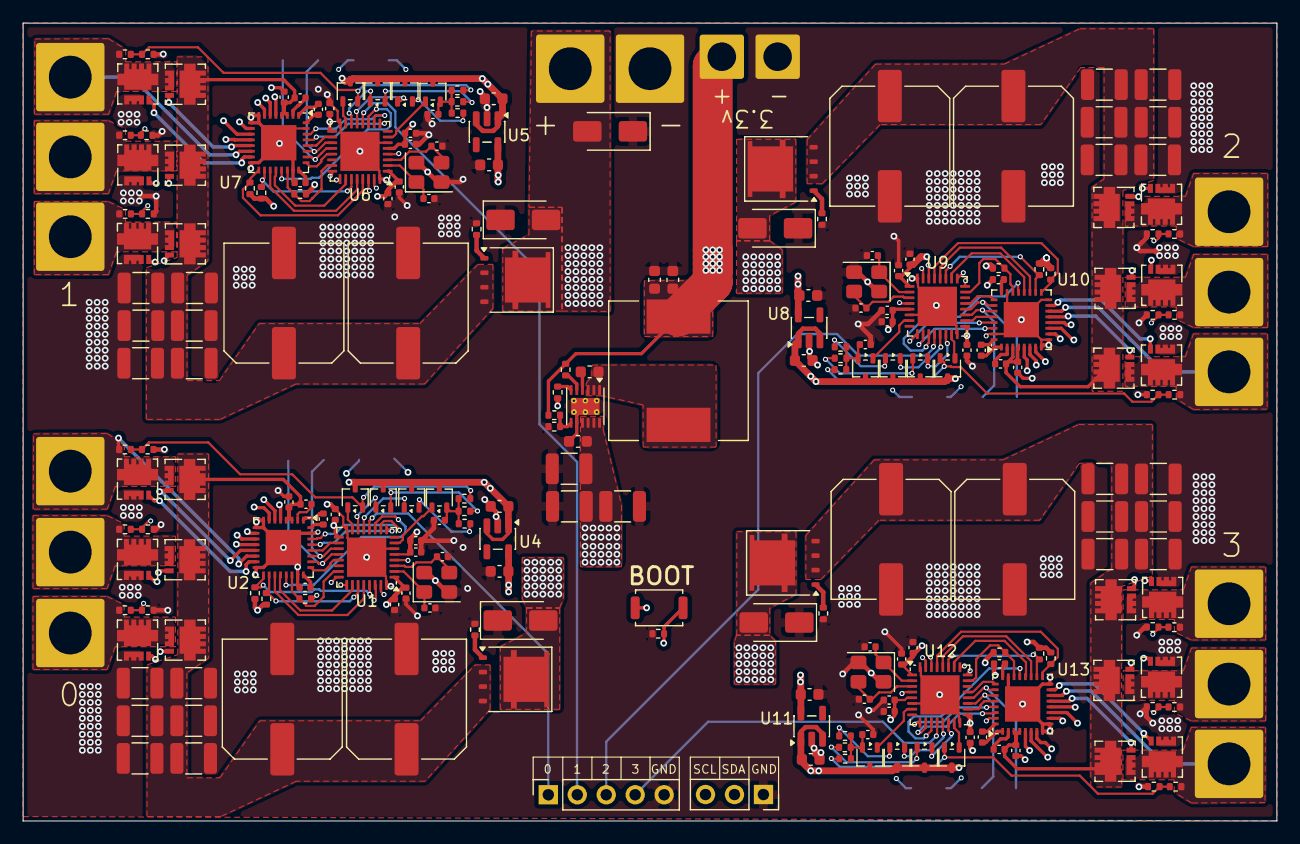
[picture p34: board Multi-ESC.kicad_pcb from above]

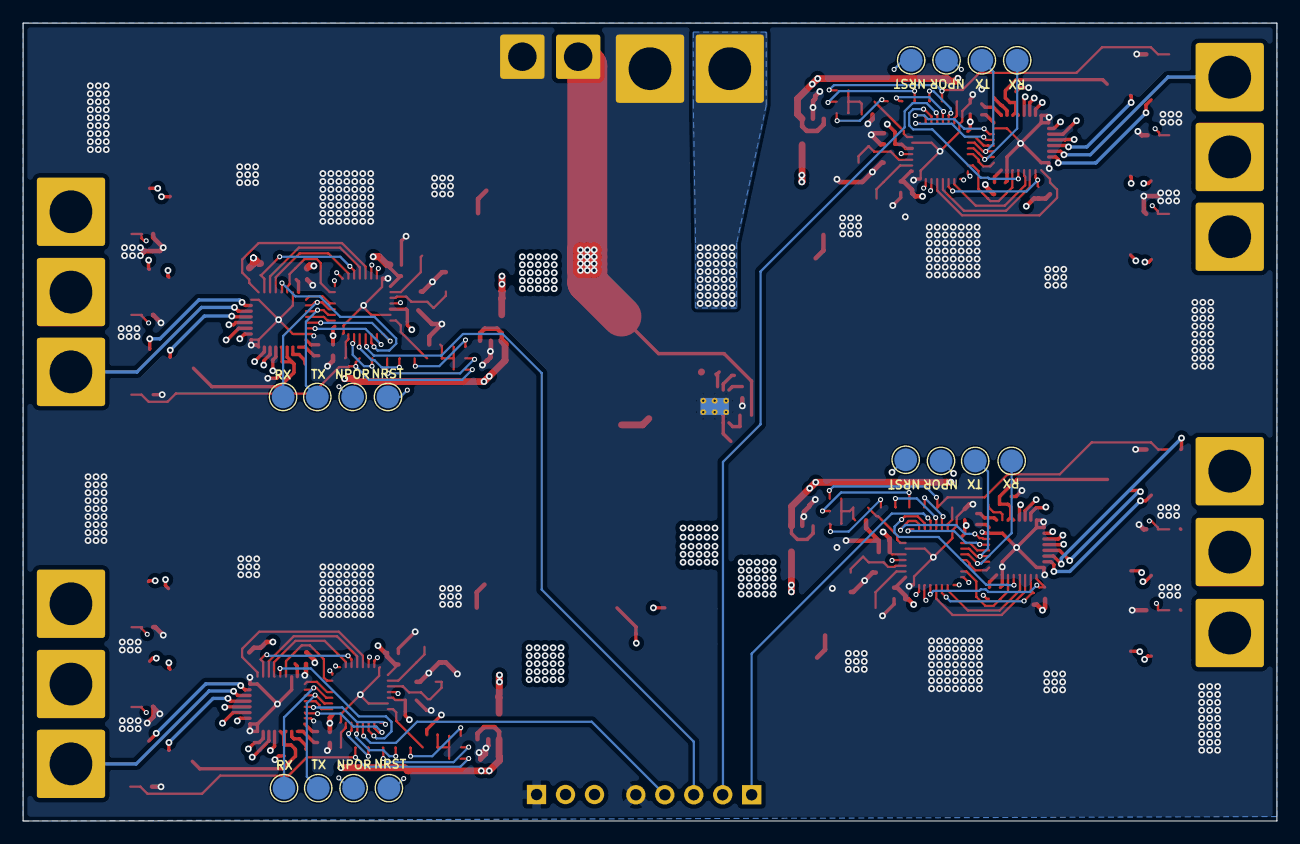
[picture p35: board Multi-ESC.kicad_pcb from below]

Board: 4 copper layers, 110.0 x 70.0 mm, 254 parts (16 on the bottom side), 175 nets.
