someonelse20/Multi-ESC/firmware/Core/Src/main.c

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
/* Includes ------------------------------------------------------------------*/
#include "main.h"

/* USER CODE BEGIN Includes */

#include <stdbool.h>
#include <stddef.h>
#include <stdint.h>
#include <sys/types.h>

#include "pid.h"
#include "stm32f3xx_hal_gpio.h"

/* USER CODE END Includes */

/* USER CODE BEGIN PD */

#define HAL_TIMEOUT 100
#define MIN_RPM 100
#define MAX_RPM 1000
#define BEMF_MIN_MARGIN 0.1 // How much above zero the BEMF voltage needs to be to read
#define BEMF_MAX_MARGIN 1   // How much below sys voltage BEMF needs to be to read
#define SET_ROTOR_TIME 10   // How long to wait in ms to set rotor to position
#define MIN_DUTY_CYCLE 0.1  // Minimum pwm duty cycle to send to gate driver

// System define
#define BEMF_A_INDEX 1
#define BEMF_B_INDEX 2
#define BEMF_C_INDEX 0
#define V_GND_INDEX 3
#define TEMP_INDEX 4

/* USER CODE END PD */

ADC_HandleTypeDef hadc1;
DMA_HandleTypeDef hdma_adc1;

I2C_HandleTypeDef hi2c1;

SPI_HandleTypeDef hspi3;

TIM_HandleTypeDef htim1;
TIM_HandleTypeDef htim2;
TIM_HandleTypeDef htim15;

/* USER CODE BEGIN PV */

const uint32_t STARTUP_DELAY = MIN_RPM / 360000; // Convert RPM to 1/6 revolutions per ms

pid_control_t speed_pid;

double rotor_angle;
double prev_rotor_angle;
double prev_rotor_angle_time;
double prev_rotor_speed_time;
double zero_cross_time;
double rotor_speed;
double input_speed;

double rotor_current[3];
double rotor_bemf[3];
double prev_rotor_bemf[3];

int8_t dir = 1;
int8_t sequence[6][3] = { // 1 is VCC, -1 is GND, and 0 is floating
	{1, -1, 0},
	{1, 0, -1},
	{0, 1, -1},
	{-1, 1, 0},
	{-1, 0, 1},
	{0, -1, 1}
};
volatile uint32_t *sequence_tim[3][2] = {
	{&TIM1->CCR4, &TIM1->CCR3},
	{&TIM1->CCR2, &TIM1->CCR1},
	{&TIM15->CCR1, &TIM15->CCR2},
};
uint32_t phase_angles[] = {0, 120, 240};
uint8_t step;
uint8_t floating;

uint32_t adc_buf[5];
/* USER CODE END PV */

void SystemClock_Config(void);
static void MX_GPIO_Init(void);
static void MX_DMA_Init(void);
static void MX_ADC1_Init(void);
static void MX_I2C1_Init(void);
static void MX_SPI3_Init(void);
static void MX_TIM1_Init(void);
static void MX_TIM2_Init(void);
static void MX_TIM15_Init(void);
/* USER CODE BEGIN PFP */

// Helper functions
static uint8_t sign(double value);
static float process_adc(uint32_t raw_value);
static float process_current(double raw_value);
static uint8_t check_valid_bemf(double bemf_v);
static double clamp(double value, double min, double max);
static double map(double value, double in_min, double in_max, double out_min, double out_max);

// Primary funcitons
static double get_rotor_angle(uint8_t floating, double rotor_speed);
static void get_rotor_bemf(double *rotor_bemf_p);
static void get_rotor_current(double *rotor_current_p);

static void drive_rotor(uint8_t step, double duty_cycle);
static void get_zero_crossing(double bemf[3], double prev_bemf[3]);

static void set_rotor(void);
static void startup_sequence(void);

/* USER CODE END PFP */

/**
 * @brief  The application entry point.
 * @retval int
 */
int main(void)
{

	/* USER CODE BEGIN 1 */
	reset_pid(&speed_pid);

	/* USER CODE END 1 */

	/* MCU Configuration--------------------------------------------------------*/

	/* Reset of all peripherals, Initializes the Flash interface and the Systick. */
	HAL_Init();

	/* Configure the system clock */
	SystemClock_Config();

	/* Initialize all configured peripherals */
	MX_GPIO_Init();
	MX_DMA_Init();
	MX_ADC1_Init();
	MX_I2C1_Init();
	MX_SPI3_Init();
	MX_TIM1_Init();
	MX_TIM2_Init();
	MX_TIM15_Init();
	/* USER CODE BEGIN 2 */

	// Start polling ADC
	HAL_ADC_Start_DMA(&hadc1, adc_buf, 5);

	// Get motor direction
	if (HAL_GPIO_ReadPin(GPIOB, 6)) {
		dir = -1;
	}

	set_rotor();

	/* USER CODE END 2 */

	/* Infinite loop */
	/* USER CODE BEGIN WHILE */
	while (1)
	{
		/* USER CODE END WHILE */

		/* USER CODE BEGIN 3 */

		get_rotor_bemf(rotor_bemf);
		get_zero_crossing(rotor_bemf, prev_rotor_bemf);
		rotor_angle = get_rotor_angle(floating, rotor_speed);

		loop_pid(&speed_pid, rotor_speed, input_speed);

		drive_rotor(step, clamp(speed_pid.output, MIN_DUTY_CYCLE, 100));

		// Update previous rotor bemf
		for (int i = 0; i < 3; i++) {
			prev_rotor_bemf[i] = rotor_bemf[i];
		}
	}
	/* USER CODE END 3 */
}

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
/* USER CODE BEGIN 4 */

void HAL_TIM_IC_CaptureCallback(TIM_HandleTypeDef *htim)
{
	if (htim->Instance == TIM2)
	{
		double duty_cycle = (HAL_TIM_ReadCapturedValue(htim, TIM_CHANNEL_1) / 4294967295.0) * 100.0;

		// Convert duty cycle to rpm
		input_speed = map(duty_cycle, 0, 100, MIN_RPM, MAX_RPM);
	}
}

static uint8_t sign(double value) {
	if (value > 0) {
		return 1;
	}

	if (value < 0) {
		return -1;
	}

	return 0;
}

static float process_adc(uint32_t raw_value) {
	return (raw_value * ADC_RESOLUTION_12B) / 3.3;
}

static uint8_t check_valid_bemf(double bemf_v) {
	if (bemf_v < BEMF_MIN_MARGIN) {
		return 1; // BEMF voltage is too small to read
	}

	return 0;
}

static double clamp(double value, double min, double max) {
	if (value < min) {
		return min;
	}

	if (value > max) {
		return max;
	}

	return value;
}

static double map(double value, double in_min, double in_max, double out_min, double out_max) {
	return (value - in_min) * (out_max - out_min) / (in_max - in_min) + out_min;
}

static double get_rotor_angle(uint8_t floating, double rotor_speed) {
	double angle = phase_angles[floating];

	double rotor_time = HAL_GetTick() - zero_cross_time;
	angle += rotor_speed * (rotor_time / 60000); // Convert rotor time to minutes.

	return angle;
}

static void get_rotor_bemf(double *rotor_bemf_p) {
	float v_gnd = process_adc(adc_buf[V_GND_INDEX]);

	// Phase A is floating
	if (floating == 0) {
		double voltage = process_adc(adc_buf[BEMF_A_INDEX]) - v_gnd;

		if (check_valid_bemf(voltage) == 1) { // BEMF is to small to detect, run startup sequence
			startup_sequence();
		}

		if (check_valid_bemf(voltage) == 2) { // BEMF is sys voltage, reading ADC at the wrong time
			return;
		}

		rotor_bemf_p[0] = voltage;
		return;
	}

	// Phase B is floating
	if (floating == 1) {
		double voltage = process_adc(adc_buf[BEMF_B_INDEX]) - v_gnd;

		if (check_valid_bemf(voltage) == 1) { // BEMF is to small to detect, run startup sequence
			startup_sequence();
		}

		if (check_valid_bemf(voltage) == 2) { // BEMF is sys voltage, reading ADC at the wrong time
			return;
		}

		rotor_bemf_p[1] = voltage;
		return;
	}

	// Phase C is floating
	if (floating == 2) {
		double voltage = process_adc(adc_buf[BEMF_C_INDEX]) - v_gnd;

		if (check_valid_bemf(voltage) == 1) { // BEMF is to small to detect, run startup sequence
			startup_sequence();
		}

		if (check_valid_bemf(voltage) == 2) { // BEMF is sys voltage, reading ADC at the wrong time
			return;
		}

		rotor_bemf_p[2] = voltage;
		return;
	}
}

static void drive_rotor(uint8_t step, double duty_cycle) {
	double duty_cycle_maped = map(duty_cycle, 0, 100, 0, 65535);

	for (int i = 0; i < 3; i++) {
		if (dir * sequence[step][i] == 0) {
			floating = i;
			*sequence_tim[i][0] = 0;
			*sequence_tim[i][1] = 0;
			continue;
		}
		if (dir * sequence[step][i] == 1) {
			*sequence_tim[i][0] = duty_cycle_maped;
			*sequence_tim[i][1] = 0;
			continue;
		}
		if (dir * sequence[step][i] == -1) {
			*sequence_tim[i][0] = 0;
			*sequence_tim[i][1] = duty_cycle_maped;
			continue;
		}
	}
}

static void get_zero_crossing(double bemf[3], double prev_bemf[3]) {
	if (sign(rotor_bemf[floating] != sign(prev_rotor_bemf[floating]))) {
		step++;
		if (step > 6) {
			step = 0;
		}

		// Update speed when zero crossing is detected.
		double time = HAL_GetTick() - zero_cross_time;
		rotor_speed = 3 * (time / 60000); // Convert to RPM

		zero_cross_time = HAL_GetTick();
	}
}

static void set_rotor(void) {
	// Set rotor to 0 degrees

	drive_rotor(0, 100);

	HAL_Delay(SET_ROTOR_TIME);
}

static void startup_sequence(void) {
	drive_rotor(step, MIN_DUTY_CYCLE);

	HAL_Delay(STARTUP_DELAY);

	step++;
}

/* USER CODE END 4 */
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
