someonelse20/Multi-ESC/firmware/firmware.ioc

Mcu.UserName=STM32F318K8Ux
PA0.Signal=ADC1_IN1
PA10.Signal=S_TIM1_CH3
PA11.Signal=S_TIM1_CH4
PA13.Signal=GPIO_Output
PA14.Signal=I2C1_SDA
PA15.Signal=I2C1_SCL
PA2.Signal=S_TIM15_CH1
PA3.Signal=S_TIM15_CH2
PA4.Signal=SPI3_NSS
PA5.Signal=S_TIM2_CH1_ETR
PA6.Signal=ADCx_IN10
PA7.Signal=ADC1_IN15
PA8.Signal=S_TIM1_CH1
PA9.Signal=S_TIM1_CH2
PB0.Signal=ADC1_IN11
PB3.Signal=SPI3_SCK
PB4.Signal=SPI3_MISO
PB5.Signal=SPI3_MOSI
PB6.Signal=GPIO_Input
PF0-OSC_IN.Signal=RCC_OSC_IN
PF1-OSC_OUT.Signal=RCC_OSC_OUT
