someonelse20/Multi-ESC/(commit log)

2026-10-08 created kicad files
    [Multi-ESC.kicad_pcb, Multi-ESC.kicad_sch]
2026-10-09 selected parts
    [Multi-ESC.kicad_sch, bldc_driver.kicad_sch]
2026-10-10 renamed gate driver symbol
2026-10-13 wired regulator
2026-10-13 started driver circuit
2026-10-13 wired mcu circuit
2026-10-13 added prog uart
2026-10-13 started wiring gate driver
2026-10-13 finished driver circuit
2026-10-13 drafted pcb
2026-10-14 added bulk capacitance
2026-10-16 started pcb layout
2026-10-19 fixed footprints
2026-10-23 set driver layout
2026-10-25 made next driver layout
2026-10-26 routing driver
2026-10-26 routed driver
2026-10-26 made rest of driver layout
2026-10-28 routing drivers 2 and 3
2026-10-28 edited footprints
2026-10-29 finished routing other drivers
2026-10-30 changed kicad lock
2026-10-30 started routing whole board
2026-11-03 routed final board
2026-11-09 added silkscreen
2026-11-09 added stm32cubemx generated code
2026-11-10 made BOM
2026-11-10 added digikey bom
